revaldinho/opc/opc7hp/doc/manual_ch1.html

## 1.1Registers

r0 = 0

r1

r2

r3

r4

r5

r6

r7

r8

r9

r10

r11

r12

r13

r14

r15 = pc

- Sixteen 32-bit registers. Most instructions name a destination register, which is also their first operand, and a source register.
- r0 always reads as zero. Writing it is allowed and changes nothing, but the flags are still set from the result, so an operation with destination r0 serves as a test.
- r15 is the program counter. Read as a source, it gives the address of the next instruction. Writing it is a jump, and a jump leaves the flags unchanged.
- Addresses and the program counter are 20 bits, so the machine addresses 1M 32-bit words. Reading r15 gives zeros in the top 12 bits. Memory is word addressed: there are no byte loads or stores.
- By software convention, the BCPL code generator uses r13 as the link register and r14 as the stack pointer.

## 1.2Processor status register

31Voverflow

3080unused

74SWIsoft int

3EIint en

2Ssign

1Ccarry

0Zzero

- Z: the result is zero. S: bit 31 of the result is set. C: the carry out of an add, subtract or compare, or the bit shifted out by a shift or rotate. V: signed overflow from an add, subtract or compare.
- EI enables hardware interrupts. Writing a non-zero SWI value with putpsr raises a software interrupt.
- Only the instructions themselves set flags. The address and operand calculation (section 1.4) never does.
- The PSR is read with getpsr and written with putpsr. getpsr puts V in bit 31 of its result, which also sets S, so getpsr followed by mi. or pl. tests overflow.

## 1.3Instruction formats

Every instruction is one 32-bit word, in one of two formats.

### Standard: opcodes 0x00 to 0x1B

3129ppppred

2824oooooopcode

2320dddddst

1916sssssrc

150imm16operand, sign extended

### Long: opcodes 0x1C to 0x1F

3129ppppred

2824111ooopcode

2320dddddst

190imm20operand, sign extended

Both immediates are sign extended to 32 bits. A 16-bit immediate covers 0x0000 to 0x7FFF and 0xFFFF8000 to 0xFFFFFFFF. The exception is in and out, whose 16-bit I/O address space accepts any 16-bit constant. Load a full 32-bit constant with mov and then movt.

## 1.4Operand and address calculation

Every instruction first forms an effective address or data value, EAD. For the standard format, EAD = src + imm16. For the long format, EAD = imm20. The instruction then uses EAD as its operand, as a memory or I/O address, or as a jump target. Choosing r0 and a zero immediate gives these modes:

Mode | Written as | EAD | Used by
Immediate | mov r1, r0, 100 | imm16 | ALU instructions
Register | add r1, r2 | src | ALU instructions
Register + immediate | add r1, r2, 4 | src + imm16 | ALU instructions
Long immediate | lmov r1, 0x12345 | imm20 | lmov, ljsr
Direct | ld r1, r0, 0x200 | mem[imm16] | loads, stores, in, out
Indirect | ld r1, r2 | mem[src] | loads, stores, in, out
Indexed | ld r1, r2, 4 | mem[src + imm16] | loads, stores, in, out
Long direct | lld r1, 0x12345 | mem[imm20] | lld, lsto
PC relative | mov pc, pc, -3 | next pc + imm16 | jumps, data near the code

There are three exceptions. bperm takes src as its value and uses imm16 as a byte selector (section 1.6). getpsr reads the PSR and ignores the immediate. rti takes its target from the saved interrupt PC.

## 1.5Predicates

Every instruction carries a predicate in bits 31 to 29, written as a prefix to its mnemonic. If the predicate fails, the instruction does nothing at all and changes no flags.

Bits 31-29 | Prefix | Executes when
000 | none, or 1. | always
001 | 0. | never: a no-operation that leaves the flags alone
010 | z. | Z set
011 | nz. | Z clear
100 | c. | C set
101 | nc. | C clear
110 | mi. | S set
111 | pl. | S clear

V has no predicate of its own. For signed comparisons, scmp sets S to the true signed result, so scmp followed by mi. or pl. gives signed less-than or greater-or-equal.

## 1.6Instruction set

Op | Mnemonic | Operation | Flags
Moves and logic
00 | mov rd, rs, imm | rd ← EAD | S Z
01 | movt rd, rs, imm | rd ← {EAD[15:0], rd[15:0]} | S Z
02 | xor rd, rs, imm | rd ← rd ^ EAD | S Z
03 | and rd, rs, imm | rd ← rd & EAD | S Z
04 | or rd, rs, imm | rd ← rd | EAD | S Z
05 | not rd, rs, imm | rd ← ~EAD | S Z
09 | bperm rd, rs, sel | rd ← bytes of rs chosen by sel | S Z
Arithmetic and compare
08 | add rd, rs, imm | {C, rd} ← rd + EAD | V S C Z
07 | sub rd, rs, imm | {C, rd} ← rd + ~EAD + 1 | V S C Z
06 | cmp rd, rs, imm | rd + ~EAD + 1, result discarded | V S C Z
16 | scmp rd, rs, imm | as cmp, with S = sign of result ^ V | V S C Z
Shifts and rotates (one place)
0A | ror rd, rs, imm | {rd, C} ← {C, EAD} | S C Z
0B | lsr rd, rs, imm | {rd, C} ← {0, EAD} | S C Z
0D | asr rd, rs, imm | {rd, C} ← {EAD[31], EAD} | S C Z
0E | rol rd, rs, imm | {C, rd} ← {EAD, C} | S C Z
Multiply and divide steps (one bit each)
0F | mulstep rd, rs, imm | rd ← {rd[30:0], 0} + (C ? EAD : 0) | S Z
17 | divstep rd, rs, imm | t = {rd, C}; t ≥ EAD: {C, rd} ← {1, t − EAD}, else {C, rd} ← {0, t[31:0]} | S C Z
Memory and I/O
1B | ld rd, rs, imm | rd ← mem[EAD] | S Z
1F | lld rd, imm20 | rd ← mem[imm20] | S Z
1A | sto rd, rs, imm | mem[EAD] ← rd | –
1E | lsto rd, imm20 | mem[imm20] ← rd | –
19 | in rd, rs, imm | rd ← io[EAD] | S Z
18 | out rd, rs, imm | io[EAD] ← rd | –
Control
0C | jsr rd, rs, imm | rd ← next pc; pc ← EAD | S Z (of the link)
1C | ljsr rd, imm20 | rd ← next pc; pc ← imm20 | S Z (of the link)
1D | lmov rd, imm20 | rd ← imm20 | S Z
11 | rti pc, pc | pc ← saved pc; flags restored | restored
12 | putpsr psr, rs, imm | PSR ← EAD; a non-zero SWI interrupts | all
13 | getpsr rd, psr | rd ← PSR | S (= V) Z
10 | halt rd, rs, imm | stop (the end of a simulation; opc7hpcpu raises hlt) | n/a

- Writing r15 with any instruction except the compares is a jump: mov pc, add pc, ld pc and so on. A jump leaves all the flags unchanged. A compare with destination r15 just compares.
- Flags not listed for an instruction keep their values. In particular, C and V change only where shown.
- add rd, rd shifts left one place, with C taking the bit shifted out.
- bperm builds each byte of the result from a 4-bit field of the selector, with byte 3 on the left. Bits 1 and 0 of a field pick a byte of rs, and bit 2 makes the byte zero. For example, 0x3210 leaves rs unchanged, 0x0123 reverses its bytes and 0x4441 moves byte 1 to byte 0 and clears the rest.
- mulstep and divstep each do one bit of a software multiply or divide, the bit coming in through C. A 32-bit multiply is 32 × (add m, m; mulstep p, b), the multiplier's bits going into C from the top, and an unsigned divide is 32 × (rol n, n; divstep r, d) and a last rol n, n, the dividend's bits going out of n into C and the quotient bits in. divstep compares 33 bits, so it can also continue a longer division.
- Unused opcodes are 0x14 and 0x15.

## 1.7Reset and interrupts

- Reset starts execution at address 0 with interrupts disabled.
- Hardware interrupts come from int_b[1:0], active low, while EI is set. An interrupt is taken as an instruction completes, and enters the handler at address 0x0004 for int_b[1] or 0x0002 for int_b[0]. If both are low, int_b[1] wins. A software interrupt, from putpsr writing a non-zero SWI, also uses 0x0002, so the handler reads the PSR to tell them apart.
- Taking an interrupt saves the return address and the flags, then clears EI. rti pc, pc returns and restores them, with SWI cleared.
- On opc7hpcpu, interrupts are precise. Everything before the interrupted point has completed, nothing after it has had any effect, and a store, in or out already sent to memory is never repeated.

## 1.8The opc7hpcpu hardware interface

Signal | Meaning
iaddr[19:0], ird | instruction fetch request
idin[31:0] | instruction reply; held until the next fetch is taken
iwait | instruction port busy: the reply isn't ready and no request is taken
address[19:0], rnw, dout[31:0] | data request; a write supplies dout
vda / vio | the data request is to memory / to the 16-bit I/O space
din[31:0] | data reply, for loads and in
dwait | data port busy, as iwait
int_b[1:0] | hardware interrupts, active low
clken | stops the whole CPU while low
hlt | high for the cycle a halt completes, so a system can stop the CPU
reset_b, clk | reset (active low, synchronised inside) and clock

Each port carries one access at a time. A request is taken at the end of a cycle in which its wait is low. The reply comes in the first later cycle with the wait low, and a write is complete as soon as it is taken. Tie both waits low for single-cycle memory such as block RAM. The waits must not depend on the CPU's outputs in the same cycle.

## 1.9Timing

The original opc7cpu runs one instruction at a time through its fetch (FET), address (EAD), memory (RDM/WRM) and execute (EXEC) states. opc7hpcpu overlaps four pipeline stages: FD (fetch), EA (address), MEM (memory) and EX (execute). It starts one instruction per cycle, apart from the costs below, and averages about 1.33 cycles per instruction on the BCPL test programs.

Case | opc7cpu | opc7hpcpu
ALU instruction | 2 | 1
Load, in | 3 | 1
Store, out | 2, plus a fetch for the next | 1
Predicate fails | 1 | 1
Unpredicated mov/lmov to pc, jsr, ljsr | 2, plus a fetch | 2
Predicated jump to an immediate or pc-relative backward target | 2, plus a fetch, if taken | 2 if taken, 4 if not
Any other taken jump (forward predicated, add pc, ld pc, rti) | 2 or 3, plus a fetch | 4
Register written by the previous instruction, needed early: an address, a source with a non-zero immediate or for bperm, store data, a jump target | no extra | +2 (+1 if written two before)
Register needed only in EX: the ALU's operands | no extra | no extra (forwarded)

opc7cpu figures are for its default build. "Plus a fetch" is one cycle, which opc7cpu otherwise overlaps with the end of the previous instruction. On opc7hpcpu each cycle with iwait or dwait high adds one, for the port it holds up.

## 1.10Changes from the original OPC7 specification

- scmp (0x16) added for signed comparisons. The original table showed it as cmp.
- Predicate 001, written 0., means never execute in all the CPUs, both emulators and the assembler. The original opc7cpu executed it.
- getpsr used to clear C in the copy it read. It now reads the PSR as it is.
- in sets S and Z from the value read, and out leaves the flags alone, the same as loads and stores.
- asr shifts in bit 31; the original table said bit 15. Shifts and rotates set C, and stores, out, writes to r15 and rti leave Z alone, which the original flag notes didn't say.
- The long forms are written ljsr, lmov, lsto and lld.
- An interrupt saves V along with the other flags, and rti restores it, as the emulators always did. The RTL used to clear V on rti.
- opc7hpcpu adds the Harvard ports, the iwait and dwait inputs and the hlt output. Interrupts are precise.
