revaldinho/opc/opc7hp/doc/opc7hp_manual.html

OPC7HP manual · draft

# OPC7HP: the Harvard, pipelined OPC7

Chapter 1 summarises the machine for programmers. Chapter 2 gives each instruction its own page, after the instruction reference in Rodnay Zaks's Programming the Z80.

## 1Programmer's summary

## 1.1Registers

r0 = 0

r1

r2

r3

r4

r5

r6

r7

r8

r9

r10

r11

r12

r13

r14

r15 = pc

- Sixteen 32-bit registers. Most instructions name a destination register, which is also their first operand, and a source register.
- r0 always reads as zero. Writing it is allowed and changes nothing, but the flags are still set from the result, so an operation with destination r0 serves as a test.
- r15 is the program counter. Read as a source, it gives the address of the next instruction. Writing it is a jump, and a jump leaves the flags unchanged.
- Addresses and the program counter are 20 bits, so the machine addresses 1M 32-bit words. Reading r15 gives zeros in the top 12 bits. Memory is word addressed: there are no byte loads or stores.
- By software convention, the BCPL code generator uses r13 as the link register and r14 as the stack pointer.

## 1.2Processor status register

31Voverflow

3080unused

74SWIsoft int

3EIint en

2Ssign

1Ccarry

0Zzero

- Z: the result is zero. S: bit 31 of the result is set. C: the carry out of an add, subtract or compare, or the bit shifted out by a shift or rotate. V: signed overflow from an add, subtract or compare.
- EI enables hardware interrupts. Writing a non-zero SWI value with putpsr raises a software interrupt.
- Only the instructions themselves set flags. The address and operand calculation (section 1.4) never does.
- The PSR is read with getpsr and written with putpsr. getpsr puts V in bit 31 of its result, which also sets S, so getpsr followed by mi. or pl. tests overflow.

## 1.3Instruction formats

Every instruction is one 32-bit word, in one of two formats.

### Standard: opcodes 0x00 to 0x1B

3129ppppred

2824oooooopcode

2320dddddst

1916sssssrc

150imm16operand, sign extended

### Long: opcodes 0x1C to 0x1F

3129ppppred

2824111ooopcode

2320dddddst

190imm20operand, sign extended

Both immediates are sign extended to 32 bits. A 16-bit immediate covers 0x0000 to 0x7FFF and 0xFFFF8000 to 0xFFFFFFFF. The exception is in and out, whose 16-bit I/O address space accepts any 16-bit constant. Load a full 32-bit constant with mov and then movt.

## 1.4Operand and address calculation

Every instruction first forms an effective address or data value, EAD. For the standard format, EAD = src + imm16. For the long format, EAD = imm20. The instruction then uses EAD as its operand, as a memory or I/O address, or as a jump target. Choosing r0 and a zero immediate gives these modes:

Mode | Written as | EAD | Used by
Immediate | mov r1, r0, 100 | imm16 | ALU instructions
Register | add r1, r2 | src | ALU instructions
Register + immediate | add r1, r2, 4 | src + imm16 | ALU instructions
Long immediate | lmov r1, 0x12345 | imm20 | lmov, ljsr
Direct | ld r1, r0, 0x200 | mem[imm16] | loads, stores, in, out
Indirect | ld r1, r2 | mem[src] | loads, stores, in, out
Indexed | ld r1, r2, 4 | mem[src + imm16] | loads, stores, in, out
Long direct | lld r1, 0x12345 | mem[imm20] | lld, lsto
PC relative | mov pc, pc, -3 | next pc + imm16 | jumps, data near the code

There are three exceptions. bperm takes src as its value and uses imm16 as a byte selector (section 1.6). getpsr reads the PSR and ignores the immediate. rti takes its target from the saved interrupt PC.

## 1.5Predicates

Every instruction carries a predicate in bits 31 to 29, written as a prefix to its mnemonic. If the predicate fails, the instruction does nothing at all and changes no flags.

Bits 31-29 | Prefix | Executes when
000 | none, or 1. | always
001 | 0. | never: a no-operation that leaves the flags alone
010 | z. | Z set
011 | nz. | Z clear
100 | c. | C set
101 | nc. | C clear
110 | mi. | S set
111 | pl. | S clear

V has no predicate of its own. For signed comparisons, scmp sets S to the true signed result, so scmp followed by mi. or pl. gives signed less-than or greater-or-equal.

## 1.6Instruction set

Op | Mnemonic | Operation | Flags
Moves and logic
00 | mov rd, rs, imm | rd ← EAD | S Z
01 | movt rd, rs, imm | rd ← {EAD[15:0], rd[15:0]} | S Z
02 | xor rd, rs, imm | rd ← rd ^ EAD | S Z
03 | and rd, rs, imm | rd ← rd & EAD | S Z
04 | or rd, rs, imm | rd ← rd | EAD | S Z
05 | not rd, rs, imm | rd ← ~EAD | S Z
09 | bperm rd, rs, sel | rd ← bytes of rs chosen by sel | S Z
Arithmetic and compare
08 | add rd, rs, imm | {C, rd} ← rd + EAD | V S C Z
07 | sub rd, rs, imm | {C, rd} ← rd + ~EAD + 1 | V S C Z
06 | cmp rd, rs, imm | rd + ~EAD + 1, result discarded | V S C Z
16 | scmp rd, rs, imm | as cmp, with S = sign of result ^ V | V S C Z
Shifts and rotates (one place)
0A | ror rd, rs, imm | {rd, C} ← {C, EAD} | S C Z
0B | lsr rd, rs, imm | {rd, C} ← {0, EAD} | S C Z
0D | asr rd, rs, imm | {rd, C} ← {EAD[31], EAD} | S C Z
0E | rol rd, rs, imm | {C, rd} ← {EAD, C} | S C Z
Multiply and divide steps (one bit each)
0F | mulstep rd, rs, imm | rd ← {rd[30:0], 0} + (C ? EAD : 0) | S Z
17 | divstep rd, rs, imm | t = {rd, C}; t ≥ EAD: {C, rd} ← {1, t − EAD}, else {C, rd} ← {0, t[31:0]} | S C Z
Memory and I/O
1B | ld rd, rs, imm | rd ← mem[EAD] | S Z
1F | lld rd, imm20 | rd ← mem[imm20] | S Z
1A | sto rd, rs, imm | mem[EAD] ← rd | –
1E | lsto rd, imm20 | mem[imm20] ← rd | –
19 | in rd, rs, imm | rd ← io[EAD] | S Z
18 | out rd, rs, imm | io[EAD] ← rd | –
Control
0C | jsr rd, rs, imm | rd ← next pc; pc ← EAD | S Z (of the link)
1C | ljsr rd, imm20 | rd ← next pc; pc ← imm20 | S Z (of the link)
1D | lmov rd, imm20 | rd ← imm20 | S Z
11 | rti pc, pc | pc ← saved pc; flags restored | restored
12 | putpsr psr, rs, imm | PSR ← EAD; a non-zero SWI interrupts | all
13 | getpsr rd, psr | rd ← PSR | S (= V) Z
10 | halt rd, rs, imm | stop (the end of a simulation; opc7hpcpu raises hlt) | n/a

- Writing r15 with any instruction except the compares is a jump: mov pc, add pc, ld pc and so on. A jump leaves all the flags unchanged. A compare with destination r15 just compares.
- Flags not listed for an instruction keep their values. In particular, C and V change only where shown.
- add rd, rd shifts left one place, with C taking the bit shifted out.
- bperm builds each byte of the result from a 4-bit field of the selector, with byte 3 on the left. Bits 1 and 0 of a field pick a byte of rs, and bit 2 makes the byte zero. For example, 0x3210 leaves rs unchanged, 0x0123 reverses its bytes and 0x4441 moves byte 1 to byte 0 and clears the rest.
- mulstep and divstep each do one bit of a software multiply or divide, the bit coming in through C. A 32-bit multiply is 32 × (add m, m; mulstep p, b), the multiplier's bits going into C from the top, and an unsigned divide is 32 × (rol n, n; divstep r, d) and a last rol n, n, the dividend's bits going out of n into C and the quotient bits in. divstep compares 33 bits, so it can also continue a longer division.
- Unused opcodes are 0x14 and 0x15.

## 1.7Reset and interrupts

- Reset starts execution at address 0 with interrupts disabled.
- Hardware interrupts come from int_b[1:0], active low, while EI is set. An interrupt is taken as an instruction completes, and enters the handler at address 0x0004 for int_b[1] or 0x0002 for int_b[0]. If both are low, int_b[1] wins. A software interrupt, from putpsr writing a non-zero SWI, also uses 0x0002, so the handler reads the PSR to tell them apart.
- Taking an interrupt saves the return address and the flags, then clears EI. rti pc, pc returns and restores them, with SWI cleared.
- On opc7hpcpu, interrupts are precise. Everything before the interrupted point has completed, nothing after it has had any effect, and a store, in or out already sent to memory is never repeated.

## 1.8The opc7hpcpu hardware interface

Signal | Meaning
iaddr[19:0], ird | instruction fetch request
idin[31:0] | instruction reply; held until the next fetch is taken
iwait | instruction port busy: the reply isn't ready and no request is taken
address[19:0], rnw, dout[31:0] | data request; a write supplies dout
vda / vio | the data request is to memory / to the 16-bit I/O space
din[31:0] | data reply, for loads and in
dwait | data port busy, as iwait
int_b[1:0] | hardware interrupts, active low
clken | stops the whole CPU while low
hlt | high for the cycle a halt completes, so a system can stop the CPU
reset_b, clk | reset (active low, synchronised inside) and clock

Each port carries one access at a time. A request is taken at the end of a cycle in which its wait is low. The reply comes in the first later cycle with the wait low, and a write is complete as soon as it is taken. Tie both waits low for single-cycle memory such as block RAM. The waits must not depend on the CPU's outputs in the same cycle.

## 1.9Timing

The original opc7cpu runs one instruction at a time through its fetch (FET), address (EAD), memory (RDM/WRM) and execute (EXEC) states. opc7hpcpu overlaps four pipeline stages: FD (fetch), EA (address), MEM (memory) and EX (execute). It starts one instruction per cycle, apart from the costs below, and averages about 1.33 cycles per instruction on the BCPL test programs.

Case | opc7cpu | opc7hpcpu
ALU instruction | 2 | 1
Load, in | 3 | 1
Store, out | 2, plus a fetch for the next | 1
Predicate fails | 1 | 1
Unpredicated mov/lmov to pc, jsr, ljsr | 2, plus a fetch | 2
Predicated jump to an immediate or pc-relative backward target | 2, plus a fetch, if taken | 2 if taken, 4 if not
Any other taken jump (forward predicated, add pc, ld pc, rti) | 2 or 3, plus a fetch | 4
Register written by the previous instruction, needed early: an address, a source with a non-zero immediate or for bperm, store data, a jump target | no extra | +2 (+1 if written two before)
Register needed only in EX: the ALU's operands | no extra | no extra (forwarded)

opc7cpu figures are for its default build. "Plus a fetch" is one cycle, which opc7cpu otherwise overlaps with the end of the previous instruction. On opc7hpcpu each cycle with iwait or dwait high adds one, for the port it holds up.

## 1.10Changes from the original OPC7 specification

- scmp (0x16) added for signed comparisons. The original table showed it as cmp.
- Predicate 001, written 0., means never execute in all the CPUs, both emulators and the assembler. The original opc7cpu executed it.
- getpsr used to clear C in the copy it read. It now reads the PSR as it is.
- in sets S and Z from the value read, and out leaves the flags alone, the same as loads and stores.
- asr shifts in bit 31; the original table said bit 15. Shifts and rotates set C, and stores, out, writes to r15 and rti leave Z alone, which the original flag notes didn't say.
- The long forms are written ljsr, lmov, lsto and lld.
- An interrupt saves V along with the other flags, and rti restores it, as the emulators always did. The RTL used to clear V on rti.
- opc7hpcpu adds the Harvard ports, the iwait and dwait inputs and the hlt output. Interrupts are precise.

## 2Instruction reference

ADD

Addopcode 0x08

Function

{C, dst} ← dst + (src + imm16)

Format

3129p p ppred

28240 1 0 0 0opcode

2320d d d ddst

1916s s s ssrc

150i i i i i i i i i i i i i i i iimm16, sign extended

Assembler: [pred.]add dst, src[, imm]; the immediate defaults to 0. One word.

Description

The source register and the sign-extended immediate are added to form the operand. The operand is then added to the destination register, and the 32-bit sum replaces it.

C is the carry out of bit 31 and V is set on signed overflow. add rd, rd shifts left one place.

Data paths

Flags

V•

SWI–

EI–

S•

C•

Z•

• set; – unchanged.

Timing

Processor | Clock cycles
opc7cpu | 2 (EAD, EXEC); 3 after a store, a jump or a skipped instruction, which need a separate fetch. 1 if the predicate fails.
opc7hpcpu | 1. The result reaches the next instruction's ALU operands without a wait. An instruction that needs it earlier, as an address, store data, a jump target, a bperm source or a source with a non-zero immediate, waits up to 2 cycles. This instruction's own source is needed early in the same way when its immediate is not zero.

Examples

Instruction | Word | Effect
add r1, r2, 0x10 | 08120010 | r1 ← r1 + r2 + 16
add r4, r4 | 08440000 | r4 ← 2 × r4; C holds the bit shifted out
nz.add r3, r0, -1 | 6830FFFF | if Z is clear, r3 ← r3 − 1
add pc, r0, 3 | 08F00003 | skip the next 3 instructions; flags kept

AND

Andopcode 0x03

Function

dst ← dst & (src + imm16)

Format

3129p p ppred

28240 0 0 1 1opcode

2320d d d ddst

1916s s s ssrc

150i i i i i i i i i i i i i i i iimm16, sign extended

Assembler: [pred.]and dst, src[, imm]; the immediate defaults to 0. One word.

Description

The destination register is anded with the source plus the immediate.

As the immediate is sign extended, a mask of 0x8000 or more in it also sets the top 16 bits. Masks such as 0xFF and 0x7FFF are fine.

Data paths

Flags

V–

SWI–

EI–

S•

C–

Z•

• set; – unchanged.

Timing

Processor | Clock cycles
opc7cpu | 2 (EAD, EXEC); 3 after a store, a jump or a skipped instruction, which need a separate fetch. 1 if the predicate fails.
opc7hpcpu | 1. The result reaches the next instruction's ALU operands without a wait. An instruction that needs it earlier, as an address, store data, a jump target, a bperm source or a source with a non-zero immediate, waits up to 2 cycles. This instruction's own source is needed early in the same way when its immediate is not zero.

Examples

Instruction | Word | Effect
and r1, r0, 0xFF | 031000FF | keep the low byte of r1
and r2, r3 | 03230000 | r2 ← r2 & r3
and r4, r0, 1 | 03400001 | Z set if r4 is even

ASR

Arithmetic shift rightopcode 0x0D

Function

{dst, C} ← {(src + imm16)[31], src + imm16}

Format

3129p p ppred

28240 1 1 0 1opcode

2320d d d ddst

1916s s s ssrc

150i i i i i i i i i i i i i i i iimm16, sign extended

Assembler: [pred.]asr dst, src[, imm]; the immediate defaults to 0. One word.

Description

The source plus the immediate is shifted right one place. Bit 31 keeps its value, so the sign is kept, and bit 0 goes into C.

This divides a signed number by two, rounding towards minus infinity.

Data paths

Flags

V–

SWI–

EI–

S•

C•

Z•

• set; – unchanged.

Timing

Processor | Clock cycles
opc7cpu | 2 (EAD, EXEC); 3 after a store, a jump or a skipped instruction, which need a separate fetch. 1 if the predicate fails.
opc7hpcpu | 1. The result reaches the next instruction's ALU operands without a wait. An instruction that needs it earlier, as an address, store data, a jump target, a bperm source or a source with a non-zero immediate, waits up to 2 cycles. This instruction's own source is needed early in the same way when its immediate is not zero.

Examples

Instruction | Word | Effect
asr r1, r1 | 0D110000 | r1 ← r1 / 2, signed
asr r2, r3 | 0D230000 | r2 ← r3 / 2, signed

BPERM

Byte permuteopcode 0x09

Function

dst ← bytes of src, chosen by imm16

Format

3129p p ppred

28240 1 0 0 1opcode

2320d d d ddst

1916s s s ssrc

150i i i i i i i i i i i i i i i iimm16, sign extended

Assembler: [pred.]bperm dst, src[, imm]; the immediate defaults to 0. One word.

Description

Each byte of the result comes from the source register as directed by a 4-bit field of the immediate. The fields are in byte order, so the leftmost hex digit controls byte 3, the top byte.

In each field, bits 1 and 0 pick a byte of the source and bit 2 makes the result byte zero instead. Unlike other instructions, the immediate isn't added to the source.

Data paths

Flags

V–

SWI–

EI–

S•

C–

Z•

• set; – unchanged.

Timing

Processor | Clock cycles
opc7cpu | 2 (EAD, EXEC); 3 after a store, a jump or a skipped instruction, which need a separate fetch. 1 if the predicate fails.
opc7hpcpu | 1. The result reaches the next instruction's ALU operands without a wait. An instruction that needs it earlier, as an address, store data, a jump target, a bperm source or a source with a non-zero immediate, waits up to 2 cycles. This instruction's own source is needed early in the same way when its immediate is not zero.

Examples

Instruction | Word | Effect
bperm r1, r2, 0x3210 | 09123210 | r1 ← r2 unchanged
bperm r1, r2, 0x0123 | 09120123 | reverse the bytes
bperm r1, r2, 0x0321 | 09120321 | rotate right by a byte
bperm r1, r2, 0x4441 | 09124441 | byte 1 of r2 to byte 0, the rest zero
bperm r1, r2, 0x0000 | 09120000 | byte 0 copied to all four

CMP

Compareopcode 0x06

Function

dst − (src + imm16), result discarded

Format

3129p p ppred

28240 0 1 1 0opcode

2320d d d ddst

1916s s s ssrc

150i i i i i i i i i i i i i i i iimm16, sign extended

Assembler: [pred.]cmp dst, src[, imm]; the immediate defaults to 0. One word.

Description

The source plus the immediate is subtracted from the destination register, as sub does, but only the flags keep the result.

Z is set if the two are equal. C is set if the destination is greater than or equal to the operand as unsigned numbers, since the subtraction is done as dst + ~operand + 1. For signed comparisons, use scmp.

With r15 as the destination it compares the next instruction's address and doesn't jump.

Data paths

Flags

V•

SWI–

EI–

S•

C•

Z•

• set; – unchanged.

Timing

Processor | Clock cycles
opc7cpu | 2 (EAD, EXEC); 3 after a store, a jump or a skipped instruction. 1 if the predicate fails.
opc7hpcpu | 1. The flags are ready for a predicated instruction straight after it. Its source is needed early when the immediate is not zero.

Examples

Instruction | Word | Effect
cmp r1, r2 | 06120000 | compare r1 with r2
cmp r1, r0, 10 | 0610000A | compare r1 with 10
z.mov r3, r0, 1 | 40300001 | after it: r3 ← 1 if they were equal
nc.mov pc, r0, 0x200 | A0F00200 | after it: jump if r1 < 10, unsigned

DIVSTEP

Divide stepopcode 0x17

Function

t = {dst, C}; {C, dst} ← t ≥ EAD ? {1, t − EAD} : {0, t[31:0]}

Format

3129p p ppred

28241 0 1 1 1opcode

2320d d d ddst

1916s s s ssrc

150i i i i i i i i i i i i i i i iimm16, sign extended

Assembler: [pred.]divstep dst, src[, imm]; the immediate defaults to 0. One word.

Description

One bit of a shift-and-subtract (restoring) divide. The destination, a partial remainder, is shifted left one place with C coming in at the bottom, giving a 33-bit value. If that is at least the source plus the immediate (unsigned), the operand is subtracted and C is set; otherwise it is kept and C is cleared. C is then the next quotient bit.

An unsigned 32-bit divide: clear the remainder and C, then 32 times rol n, n (the quotient bit from C in at the bottom of n, the next dividend bit out of its top into C) and divstep r, d, and a last rol n, n. n then holds the quotient and r the remainder. The comparison is of 33 bits, so the same steps also continue a division of a longer dividend.

Data paths

Flags

V–

SWI–

EI–

S•

C•

Z•

• set; – unchanged. C = the quotient bit.

Timing

Processor | Clock cycles
opc7cpu | 2 (EAD, EXEC); 3 after a store, a jump or a skipped instruction, which need a separate fetch. 1 if the predicate fails.
opc7hpcpu | 1. The result reaches the next instruction's ALU operands without a wait. An instruction that needs it earlier, as an address, store data, a jump target, a bperm source or a source with a non-zero immediate, waits up to 2 cycles. This instruction's own source is needed early in the same way when its immediate is not zero.

Examples

Instruction | Word | Effect
rol r1, r1 | 0E110000 | quotient bit in, next dividend bit out to C
divstep r3, r2 | 17320000 | r3 ← 2 × r3 + C, less r2 if that is ≥ r2; C ← the quotient bit
divstep r3, r0, 10 | 1730000A | one bit of a divide by 10

GETPSR

Get processor status registeropcode 0x13

Function

dst ← PSR

Format

3129p p ppred

28241 0 0 1 1opcode

2320d d d ddst

1916s s s ssrc

150i i i i i i i i i i i i i i i iimm16, sign extended

Assembler: [pred.]getpsr dst, psr. One word.

Description

The PSR is copied to the destination register. The immediate is ignored.

V is in bit 31 of the copy, so the S flag that the copy sets equals V. That makes getpsr then mi. or pl. a test for overflow.

Data paths

Flags

V–

SWI–

EI–

S•

C–

Z•

• set; – unchanged. S = V.

Timing

Processor | Clock cycles
opc7cpu | 2 (EAD, EXEC); 3 after a store, a jump or a skipped instruction, which need a separate fetch. 1 if the predicate fails.
opc7hpcpu | 1. The result reaches the next instruction's ALU operands without a wait. An instruction that needs it earlier, as an address, store data, a jump target, a bperm source or a source with a non-zero immediate, waits up to 2 cycles. This instruction's own source is needed early in the same way when its immediate is not zero.

Examples

Instruction | Word | Effect
getpsr r1, psr | 13100000 | r1 ← PSR
getpsr r0, psr | 13000000 | only set S from V
mi.mov pc, r0, 0x300 | C0F00300 | after it: jump if V was set

HALT

Haltopcode 0x10

Function

stop

Format

3129p p ppred

28241 0 0 0 0opcode

2320d d d ddst

1916s s s ssrc

150i i i i i i i i i i i i i i i iimm16, sign extended

Assembler: halt r0, r0, number. One word.

Description

Ends a program. The emulators and testbenches stop and report the immediate as the halt number.

On opc7hpcpu the instruction raises the hlt output as it completes, and the system around it stops the CPU there. The CPU itself carries on.

Data paths

Flags

V–

SWI–

EI–

S–

C–

Z–

N/a.

Timing

Processor | Clock cycles
opc7cpu | n/a
opc7hpcpu | The CPU is stopped by the system as halt completes.

Examples

Instruction | Word | Effect
halt r0, r0, 0x99 | 10000099 | stop, halt number 0x99

IN

Inputopcode 0x19

Function

dst ← io[src + imm16]

Format

3129p p ppred

28241 1 0 0 1opcode

2320d d d ddst

1916s s s ssrc

150i i i i i i i i i i i i i i i iimm16, sign extended

Assembler: [pred.]in dst, src[, imm]; the immediate defaults to 0. One word.

Description

The I/O port at the source plus the immediate is read into the destination register, which sets S and Z. The access uses vio, and the port address is 16 bits.

In the emulators, every in reads the next character of standard input, whatever the port.

Data paths

Flags

V–

SWI–

EI–

S•

C–

Z•

• set; – unchanged.

Timing

Processor | Clock cycles
opc7cpu | 3 (EAD, RDM, EXEC); 4 after a store, a jump or a skipped instruction. 1 if the predicate fails.
opc7hpcpu | 1, with memory that answers at once. Its address register is needed early: up to 2 cycles' wait if one of the two instructions before wrote it. The value read reaches the next instruction's ALU operands without a wait, and an address 2 cycles later. Each cycle the port's wait input is high adds one.

Examples

Instruction | Word | Effect
in r1, r0, 0x00 | 19100000 | read port 0 (the system UART's status)
in r2, r0, 0x10 | 19200010 | read the GPIO input pins

JSR

Jump to subroutineopcode 0x0C

Function

dst ← next pc; pc ← src + imm16

Format

3129p p ppred

28240 1 1 0 0opcode

2320d d d ddst

1916s s s ssrc

150i i i i i i i i i i i i i i i iimm16, sign extended

Assembler: [pred.]jsr dst, src[, imm]; the immediate defaults to 0. One word.

Description

The address of the next instruction is saved in the destination register, the link, and execution continues at the source plus the immediate.

Return with mov pc, rlink. BCPL code uses r13 as the link. With r0 as the destination it is a plain jump.

Data paths

Flags

V–

SWI–

EI–

S•

C–

Z•

• set; – unchanged. Of the link.

Timing

Processor | Clock cycles
opc7cpu | 2, and the target then needs a separate fetch. 1 if the predicate fails.
opc7hpcpu | 2 when unpredicated: it redirects the fetch as it leaves EA, losing one cycle. Its source is needed early. A predicated one with an immediate or pc-relative backward target is predicted taken: 2 if it is, 4 if not. Any other taken jump of this kind costs 4.

Examples

Instruction | Word | Effect
jsr r13, r0, 0x1234 | 0CD01234 | call the routine at 0x1234
jsr r13, r4 | 0CD40000 | call through r4
mov pc, r13 | 00FD0000 | and return

LD

Loadopcode 0x1B

Function

dst ← mem[src + imm16]

Format

3129p p ppred

28241 1 0 1 1opcode

2320d d d ddst

1916s s s ssrc

150i i i i i i i i i i i i i i i iimm16, sign extended

Assembler: [pred.]ld dst, src[, imm]; the immediate defaults to 0. One word.

Description

The source register and the sign-extended immediate are added to form a word address. Its low 20 bits select one of the 1M words of memory, and that word replaces the destination register.

With r0 as the source the immediate is an absolute address in the first 32K words, and lld reaches all 1M. A destination of r15 jumps to the loaded address, as through a jump table.

Data paths

Flags

V–

SWI–

EI–

S•

C–

Z•

• set; – unchanged.

Timing

Processor | Clock cycles
opc7cpu | 3 (EAD, RDM, EXEC); 4 after a store, a jump or a skipped instruction. 1 if the predicate fails.
opc7hpcpu | 1, with memory that answers at once. Its address register is needed early: up to 2 cycles' wait if one of the two instructions before wrote it. The value read reaches the next instruction's ALU operands without a wait, and an address 2 cycles later. Each cycle the port's wait input is high adds one.

Examples

Instruction | Word | Effect
ld r1, r2, 4 | 1B120004 | r1 ← the word 4 after r2
ld r5, r11, -2 | 1B5BFFFE | r5 ← the word 2 before r11
mi.ld r6, r12, 94 | DB6C005E | if S is set, r6 ← mem[r12 + 94]
ld pc, r0, 0x200 | 1BF00200 | jump to the address held at 0x200

LJSR

Long jump to subroutineopcode 0x1C

Function

dst ← next pc; pc ← imm20

Format

3129p p ppred

28241 1 1 0 0opcode

2320d d d ddst

190i i i i i i i i i i i i i i i i i i i iimm20, sign extended

Assembler: [pred.]ljsr dst, imm20. Long format: no source field. One word.

Description

As jsr, with the target a 20-bit address in the instruction, so it reaches the whole address space.

Data paths

Flags

V–

SWI–

EI–

S•

C–

Z•

• set; – unchanged. Of the link.

Timing

Processor | Clock cycles
opc7cpu | 2, and the target then needs a separate fetch. 1 if the predicate fails.
opc7hpcpu | 2 when unpredicated: it redirects the fetch as it leaves EA, losing one cycle. Its source is needed early. A predicated one with an immediate or pc-relative backward target is predicted taken: 2 if it is, 4 if not. Any other taken jump of this kind costs 4.

Examples

Instruction | Word | Effect
ljsr r13, 0x1000 | 1CD01000 | call the routine at 0x01000

LLD

Long loadopcode 0x1F

Function

dst ← mem[imm20]

Format

3129p p ppred

28241 1 1 1 1opcode

2320d d d ddst

190i i i i i i i i i i i i i i i i i i i iimm20, sign extended

Assembler: [pred.]lld dst, imm20. Long format: no source field. One word.

Description

The word at the 20-bit address in the instruction replaces the destination register.

Data paths

Flags

V–

SWI–

EI–

S•

C–

Z•

• set; – unchanged.

Timing

Processor | Clock cycles
opc7cpu | 3 (EAD, RDM, EXEC); 4 after a store, a jump or a skipped instruction. 1 if the predicate fails.
opc7hpcpu | 1, with memory that answers at once. Its address register is needed early: up to 2 cycles' wait if one of the two instructions before wrote it. The value read reaches the next instruction's ALU operands without a wait, and an address 2 cycles later. Each cycle the port's wait input is high adds one.

Examples

Instruction | Word | Effect
lld r1, 0x12345 | 1F112345 | r1 ← mem[0x12345]
lld pc, 0x00010 | 1FF00010 | jump to the address held at 0x10

LMOV

Long moveopcode 0x1D

Function

dst ← imm20

Format

3129p p ppred

28241 1 1 0 1opcode

2320d d d ddst

190i i i i i i i i i i i i i i i i i i i iimm20, sign extended

Assembler: [pred.]lmov dst, imm20. Long format: no source field. One word.

Description

The sign-extended 20-bit immediate replaces the destination register, giving constants from −524288 to 524287 in one instruction.

With r15 as the destination it is a jump to any address.

Data paths

Flags

V–

SWI–

EI–

S•

C–

Z•

• set; – unchanged.

Timing

Processor | Clock cycles
opc7cpu | 2 (EAD, EXEC); 3 after a store, a jump or a skipped instruction, which need a separate fetch. 1 if the predicate fails.
opc7hpcpu | 1. The result reaches the next instruction's ALU operands without a wait. An instruction that needs it earlier, as an address, store data, a jump target, a bperm source or a source with a non-zero immediate, waits up to 2 cycles. This instruction's own source is needed early in the same way when its immediate is not zero.

Examples

Instruction | Word | Effect
lmov r1, 0x12345 | 1D112345 | r1 ← 0x12345
lmov r2, -100000 | 1D2E7960 | r2 ← −100000
lmov pc, 0x1000 | 1DF01000 | jump to 0x01000

LSR

Logical shift rightopcode 0x0B

Function

{dst, C} ← {0, src + imm16}

Format

3129p p ppred

28240 1 0 1 1opcode

2320d d d ddst

1916s s s ssrc

150i i i i i i i i i i i i i i i iimm16, sign extended

Assembler: [pred.]lsr dst, src[, imm]; the immediate defaults to 0. One word.

Description

The source plus the immediate is shifted right one place. Zero goes into bit 31, and bit 0 goes into C.

Data paths

Flags

V–

SWI–

EI–

S•

C•

Z•

• set; – unchanged.

Timing

Processor | Clock cycles
opc7cpu | 2 (EAD, EXEC); 3 after a store, a jump or a skipped instruction, which need a separate fetch. 1 if the predicate fails.
opc7hpcpu | 1. The result reaches the next instruction's ALU operands without a wait. An instruction that needs it earlier, as an address, store data, a jump target, a bperm source or a source with a non-zero immediate, waits up to 2 cycles. This instruction's own source is needed early in the same way when its immediate is not zero.

Examples

Instruction | Word | Effect
lsr r1, r1 | 0B110000 | r1 ← r1 / 2, unsigned
lsr r2, r3 | 0B230000 | r2 ← r3 / 2, unsigned; C holds the remainder

LSTO

Long storeopcode 0x1E

Function

mem[imm20] ← dst

Format

3129p p ppred

28241 1 1 1 0opcode

2320d d d ddst

190i i i i i i i i i i i i i i i i i i i iimm20, sign extended

Assembler: [pred.]lsto dst, imm20. Long format: no source field. One word.

Description

The destination register is written to the 20-bit address in the instruction. The flags are unchanged.

Data paths

Flags

V–

SWI–

EI–

S–

C–

Z–

Unchanged.

Timing

Processor | Clock cycles
opc7cpu | 2 (EAD, WRM), and the next instruction then needs a separate fetch. 1 if the predicate fails.
opc7hpcpu | 1. Its address and its data register are both needed early: up to 2 cycles' wait if one of the two instructions before wrote them. It waits while a jump or anything else that could change the flow is ahead of it in the pipeline, so that it never acts and is then cancelled.

Examples

Instruction | Word | Effect
lsto r1, 0x12345 | 1E112345 | mem[0x12345] ← r1

MOV

Moveopcode 0x00

Function

dst ← src + imm16

Format

3129p p ppred

28240 0 0 0 0opcode

2320d d d ddst

1916s s s ssrc

150i i i i i i i i i i i i i i i iimm16, sign extended

Assembler: [pred.]mov dst, src[, imm]; the immediate defaults to 0. One word.

Description

The source register plus the sign-extended immediate replaces the destination register.

With r0 as the source this loads a constant from −32768 to 32767. Use movt after it for the top half of a 32-bit constant, or lmov for 20 bits.

With r15 as the destination it is a jump: to an absolute address with r0 as the source, relative to the next instruction with r15, or through a register, as in mov pc, r13 to return from a subroutine.

Data paths

Flags

V–

SWI–

EI–

S•

C–

Z•

• set; – unchanged.

Timing

Processor | Clock cycles
opc7cpu | 2 (EAD, EXEC); 3 after a store, a jump or a skipped instruction, which need a separate fetch. 1 if the predicate fails.
opc7hpcpu | 1. The result reaches the next instruction's ALU operands without a wait. An instruction that needs it earlier, as an address, store data, a jump target, a bperm source or a source with a non-zero immediate, waits up to 2 cycles. This instruction's own source is needed early in the same way when its immediate is not zero.

Examples

Instruction | Word | Effect
mov r1, r0, 100 | 00100064 | r1 ← 100
mov r2, r3 | 00230000 | r2 ← r3
mov r4, r5, -1 | 0045FFFF | r4 ← r5 − 1
mov pc, r13 | 00FD0000 | return through the link in r13
nz.mov pc, pc, -3 | 60FFFFFD | if Z is clear, jump back 2 instructions

MOVT

Move topopcode 0x01

Function

dst ← {(src + imm16)[15:0], dst[15:0]}

Format

3129p p ppred

28240 0 0 0 1opcode

2320d d d ddst

1916s s s ssrc

150i i i i i i i i i i i i i i i iimm16, sign extended

Assembler: [pred.]movt dst, src[, imm]; the immediate defaults to 0. One word.

Description

The low 16 bits of the source plus the immediate replace the top half of the destination register. Its bottom half is unchanged.

After a mov of the low half, this completes a 32-bit constant.

Data paths

Flags

V–

SWI–

EI–

S•

C–

Z•

• set; – unchanged.

Timing

Processor | Clock cycles
opc7cpu | 2 (EAD, EXEC); 3 after a store, a jump or a skipped instruction, which need a separate fetch. 1 if the predicate fails.
opc7hpcpu | 1. The result reaches the next instruction's ALU operands without a wait. An instruction that needs it earlier, as an address, store data, a jump target, a bperm source or a source with a non-zero immediate, waits up to 2 cycles. This instruction's own source is needed early in the same way when its immediate is not zero.

Examples

Instruction | Word | Effect
mov r1, r0, 0x5678 | 00105678 | r1 ← 0x00005678
movt r1, r0, 0x1234 | 01101234 | r1 ← 0x12345678
movt r2, r0 | 01200000 | clear the top half of r2

MULSTEP

Multiply stepopcode 0x0F

Function

dst ← {dst[30:0], 0} + (C ? src + imm16 : 0)

Format

3129p p ppred

28240 1 1 1 1opcode

2320d d d ddst

1916s s s ssrc

150i i i i i i i i i i i i i i i iimm16, sign extended

Assembler: [pred.]mulstep dst, src[, imm]; the immediate defaults to 0. One word.

Description

One bit of a shift-and-add multiply. The destination is shifted left one place, and if C is set the source plus the immediate is added to it. C and V are left alone, so the next multiplier bit can come in through C.

A product (the low 32 bits, the same for signed and unsigned operands) is formed from the top of the multiplier down: clear the product, then for each multiplier bit shift it into C with add m, m and do mulstep p, b. Skipping the multiplier's leading zero bytes first makes small multipliers quick.

Data paths

Flags

V–

SWI–

EI–

S•

C–

Z•

• set; – unchanged.

Timing

Processor | Clock cycles
opc7cpu | 2 (EAD, EXEC); 3 after a store, a jump or a skipped instruction, which need a separate fetch. 1 if the predicate fails.
opc7hpcpu | 1. The result reaches the next instruction's ALU operands without a wait. An instruction that needs it earlier, as an address, store data, a jump target, a bperm source or a source with a non-zero immediate, waits up to 2 cycles. This instruction's own source is needed early in the same way when its immediate is not zero.

Examples

Instruction | Word | Effect
add r3, r3 | 08330000 | next multiplier bit (top first) to C
mulstep r1, r2 | 0F120000 | r1 ← 2 × r1 + (C ? r2 : 0)
mulstep r1, r0, 10 | 0F10000A | r1 ← 2 × r1 + (C ? 10 : 0)

NOT

Notopcode 0x05

Function

dst ← ~(src + imm16)

Format

3129p p ppred

28240 0 1 0 1opcode

2320d d d ddst

1916s s s ssrc

150i i i i i i i i i i i i i i i iimm16, sign extended

Assembler: [pred.]not dst, src[, imm]; the immediate defaults to 0. One word.

Description

The ones complement of the source plus the immediate replaces the destination register.

With an immediate of −1 this is negation, since −x = ~(x − 1).

Data paths

Flags

V–

SWI–

EI–

S•

C–

Z•

• set; – unchanged.

Timing

Processor | Clock cycles
opc7cpu | 2 (EAD, EXEC); 3 after a store, a jump or a skipped instruction, which need a separate fetch. 1 if the predicate fails.
opc7hpcpu | 1. The result reaches the next instruction's ALU operands without a wait. An instruction that needs it earlier, as an address, store data, a jump target, a bperm source or a source with a non-zero immediate, waits up to 2 cycles. This instruction's own source is needed early in the same way when its immediate is not zero.

Examples

Instruction | Word | Effect
not r1, r2 | 05120000 | r1 ← ~r2
not r3, r3, -1 | 0533FFFF | r3 ← −r3
not r4, r0 | 05400000 | r4 ← 0xFFFFFFFF

OR

Oropcode 0x04

Function

dst ← dst | (src + imm16)

Format

3129p p ppred

28240 0 1 0 0opcode

2320d d d ddst

1916s s s ssrc

150i i i i i i i i i i i i i i i iimm16, sign extended

Assembler: [pred.]or dst, src[, imm]; the immediate defaults to 0. One word.

Description

The destination register is ored with the source plus the immediate.

Data paths

Flags

V–

SWI–

EI–

S•

C–

Z•

• set; – unchanged.

Timing

Processor | Clock cycles
opc7cpu | 2 (EAD, EXEC); 3 after a store, a jump or a skipped instruction, which need a separate fetch. 1 if the predicate fails.
opc7hpcpu | 1. The result reaches the next instruction's ALU operands without a wait. An instruction that needs it earlier, as an address, store data, a jump target, a bperm source or a source with a non-zero immediate, waits up to 2 cycles. This instruction's own source is needed early in the same way when its immediate is not zero.

Examples

Instruction | Word | Effect
or r1, r2 | 04120000 | r1 ← r1 | r2
or r3, r0, 0x80 | 04300080 | set bit 7 of r3
or r4, r0 | 04400000 | test r4: S and Z from its value

OUT

Outputopcode 0x18

Function

io[src + imm16] ← dst

Format

3129p p ppred

28241 1 0 0 0opcode

2320d d d ddst

1916s s s ssrc

150i i i i i i i i i i i i i i i iimm16, sign extended

Assembler: [pred.]out dst, src[, imm]; the immediate defaults to 0. One word.

Description

The destination register is written to the I/O port at the source plus the immediate. The I/O space is separate from memory: the CPU signals the access with vio rather than vda, and the port address is 16 bits.

Any 16-bit constant is a valid port number here. The flags are unchanged.

Data paths

Flags

V–

SWI–

EI–

S–

C–

Z–

Unchanged.

Timing

Processor | Clock cycles
opc7cpu | 2 (EAD, WRM), and the next instruction then needs a separate fetch. 1 if the predicate fails.
opc7hpcpu | 1. Its address and its data register are both needed early: up to 2 cycles' wait if one of the two instructions before wrote them. It waits while a jump or anything else that could change the flow is ahead of it in the pipeline, so that it never acts and is then cancelled.

Examples

Instruction | Word | Effect
out r1, r0, 0x01 | 18100001 | write r1 to port 1 (the system UART's data)
out r2, r3, 0x10 | 18230010 | write r2 to port r3 + 16

PUTPSR

Put processor status registeropcode 0x12

Function

PSR ← src + imm16

Format

3129p p ppred

28241 0 0 1 0opcode

2320d d d ddst

1916s s s ssrc

150i i i i i i i i i i i i i i i iimm16, sign extended

Assembler: [pred.]putpsr psr, src[, imm]. One word.

Description

The source plus the immediate replaces the PSR: V from bit 31, SWI from bits 7 to 4, then EI, S, C and Z from bits 3 to 0.

A non-zero SWI value raises a software interrupt as the instruction completes. It enters the handler at 0x0002 with the return address of the next instruction. Setting EI enables hardware interrupts.

Data paths

Flags

V•

SWI•

EI•

S•

C•

Z•

• set; – unchanged. All from the operand.

Timing

Processor | Clock cycles
opc7cpu | 2 (EAD, EXEC); 3 after a store, a jump or a skipped instruction. 1 if the predicate fails.
opc7hpcpu | 1. Stores, in and out behind it wait until it completes, since it can raise a software interrupt. A software interrupt costs as a taken jump.

Examples

Instruction | Word | Effect
putpsr psr, r0, 0x08 | 12000008 | enable interrupts, clear the flags
putpsr psr, r1 | 12010000 | PSR ← r1
putpsr psr, r0, 0x18 | 12000018 | software interrupt 1, interrupts enabled

ROL

Rotate left through carryopcode 0x0E

Function

{C, dst} ← {src + imm16, C}

Format

3129p p ppred

28240 1 1 1 0opcode

2320d d d ddst

1916s s s ssrc

150i i i i i i i i i i i i i i i iimm16, sign extended

Assembler: [pred.]rol dst, src[, imm]; the immediate defaults to 0. One word.

Description

The source plus the immediate is shifted left one place. C goes into bit 0, and bit 31 goes into C.

A chain of rol instructions shifts a multi-word value left.

Data paths

Flags

V–

SWI–

EI–

S•

C•

Z•

• set; – unchanged.

Timing

Processor | Clock cycles
opc7cpu | 2 (EAD, EXEC); 3 after a store, a jump or a skipped instruction, which need a separate fetch. 1 if the predicate fails.
opc7hpcpu | 1. The result reaches the next instruction's ALU operands without a wait. An instruction that needs it earlier, as an address, store data, a jump target, a bperm source or a source with a non-zero immediate, waits up to 2 cycles. This instruction's own source is needed early in the same way when its immediate is not zero.

Examples

Instruction | Word | Effect
rol r1, r1 | 0E110000 | rotate r1 left through C
rol r2, r3 | 0E230000 | r2 ← r3 rotated left through C

ROR

Rotate right through carryopcode 0x0A

Function

{dst, C} ← {C, src + imm16}

Format

3129p p ppred

28240 1 0 1 0opcode

2320d d d ddst

1916s s s ssrc

150i i i i i i i i i i i i i i i iimm16, sign extended

Assembler: [pred.]ror dst, src[, imm]; the immediate defaults to 0. One word.

Description

The source plus the immediate is shifted right one place. C goes into bit 31, and bit 0 goes into C.

A chain of ror instructions shifts a multi-word value right.

Data paths

Flags

V–

SWI–

EI–

S•

C•

Z•

• set; – unchanged.

Timing

Processor | Clock cycles
opc7cpu | 2 (EAD, EXEC); 3 after a store, a jump or a skipped instruction, which need a separate fetch. 1 if the predicate fails.
opc7hpcpu | 1. The result reaches the next instruction's ALU operands without a wait. An instruction that needs it earlier, as an address, store data, a jump target, a bperm source or a source with a non-zero immediate, waits up to 2 cycles. This instruction's own source is needed early in the same way when its immediate is not zero.

Examples

Instruction | Word | Effect
ror r1, r1 | 0A110000 | rotate r1 right through C
ror r2, r3 | 0A230000 | r2 ← r3 rotated right through C

RTI

Return from interruptopcode 0x11

Function

pc ← saved pc; flags ← saved flags

Format

3129p p ppred

28241 0 0 0 1opcode

2320d d d ddst

1916s s s ssrc

150i i i i i i i i i i i i i i i iimm16, sign extended

Assembler: rti pc, pc. One word.

Description

Returns from an interrupt handler to the instruction where the interrupt was taken, and restores the flags saved then: V, EI, S, C and Z. The SWI bits are cleared.

Written rti pc, pc. Since EI is restored, interrupts are enabled again if they were enabled before.

Data paths

Flags

V•

SWI•

EI•

S•

C•

Z•

• set; – unchanged. Restored.

Timing

Processor | Clock cycles
opc7cpu | 2 or 3, and the target then needs a separate fetch. 1 if the predicate fails.
opc7hpcpu | 4 when the jump is taken: it is decided in EX, and the three instructions behind it are cancelled.

Examples

Instruction | Word | Effect
rti pc, pc | 11FF0000 | return from the handler

SCMP

Signed compareopcode 0x16

Function

dst − (src + imm16), with S = signed less-than

Format

3129p p ppred

28241 0 1 1 0opcode

2320d d d ddst

1916s s s ssrc

150i i i i i i i i i i i i i i i iimm16, sign extended

Assembler: [pred.]scmp dst, src[, imm]; the immediate defaults to 0. One word.

Description

Compares as cmp does, but sets S to the sign of the result exclusive-ored with V. S is then set exactly when the destination is less than the operand as signed numbers, even when the subtraction overflows.

So mi. after scmp means signed less-than, and pl. means signed greater-than-or-equal. V, C and Z are set as for cmp.

Data paths

Flags

V•

SWI–

EI–

S•

C•

Z•

• set; – unchanged. S = sign ^ V.

Timing

Processor | Clock cycles
opc7cpu | 2 (EAD, EXEC); 3 after a store, a jump or a skipped instruction. 1 if the predicate fails.
opc7hpcpu | 1. The flags are ready for a predicated instruction straight after it. Its source is needed early when the immediate is not zero.

Examples

Instruction | Word | Effect
scmp r1, r2 | 16120000 | compare r1 with r2, signed
mi.mov pc, r0, 0x400 | C0F00400 | after it: jump if r1 < r2, signed
scmp r1, r0, -5 | 1610FFFB | compare r1 with −5, signed

STO

Storeopcode 0x1A

Function

mem[src + imm16] ← dst

Format

3129p p ppred

28241 1 0 1 0opcode

2320d d d ddst

1916s s s ssrc

150i i i i i i i i i i i i i i i iimm16, sign extended

Assembler: [pred.]sto dst, src[, imm]; the immediate defaults to 0. One word.

Description

The destination register is written to memory at the source plus the immediate, a word address of which the low 20 bits are used. The flags are unchanged.

Note that the register written to memory is the one in the destination field.

Data paths

Flags

V–

SWI–

EI–

S–

C–

Z–

Unchanged.

Timing

Processor | Clock cycles
opc7cpu | 2 (EAD, WRM), and the next instruction then needs a separate fetch. 1 if the predicate fails.
opc7hpcpu | 1. Its address and its data register are both needed early: up to 2 cycles' wait if one of the two instructions before wrote them. It waits while a jump or anything else that could change the flow is ahead of it in the pipeline, so that it never acts and is then cancelled.

Examples

Instruction | Word | Effect
sto r1, r2 | 1A120000 | mem[r2] ← r1
sto r1, r11, 3 | 1A1B0003 | mem[r11 + 3] ← r1
sto r0, r0, 0x200 | 1A000200 | mem[0x200] ← 0

SUB

Subtractopcode 0x07

Function

{C, dst} ← dst + ~(src + imm16) + 1

Format

3129p p ppred

28240 0 1 1 1opcode

2320d d d ddst

1916s s s ssrc

150i i i i i i i i i i i i i i i iimm16, sign extended

Assembler: [pred.]sub dst, src[, imm]; the immediate defaults to 0. One word.

Description

The source plus the immediate is subtracted from the destination register.

C is set when there is no borrow, that is when the destination was greater than or equal to the operand as unsigned numbers. V is set on signed overflow.

Data paths

Flags

V•

SWI–

EI–

S•

C•

Z•

• set; – unchanged.

Timing

Processor | Clock cycles
opc7cpu | 2 (EAD, EXEC); 3 after a store, a jump or a skipped instruction, which need a separate fetch. 1 if the predicate fails.
opc7hpcpu | 1. The result reaches the next instruction's ALU operands without a wait. An instruction that needs it earlier, as an address, store data, a jump target, a bperm source or a source with a non-zero immediate, waits up to 2 cycles. This instruction's own source is needed early in the same way when its immediate is not zero.

Examples

Instruction | Word | Effect
sub r1, r2 | 07120000 | r1 ← r1 − r2
sub r3, r0, 1 | 07300001 | r3 ← r3 − 1, Z set at zero
sub r4, r4 | 07440000 | r4 ← 0, C set

XOR

Exclusive oropcode 0x02

Function

dst ← dst ^ (src + imm16)

Format

3129p p ppred

28240 0 0 1 0opcode

2320d d d ddst

1916s s s ssrc

150i i i i i i i i i i i i i i i iimm16, sign extended

Assembler: [pred.]xor dst, src[, imm]; the immediate defaults to 0. One word.

Description

The destination register is exclusive-ored with the source plus the immediate.

Data paths

Flags

V–

SWI–

EI–

S•

C–

Z•

• set; – unchanged.

Timing

Processor | Clock cycles
opc7cpu | 2 (EAD, EXEC); 3 after a store, a jump or a skipped instruction, which need a separate fetch. 1 if the predicate fails.
opc7hpcpu | 1. The result reaches the next instruction's ALU operands without a wait. An instruction that needs it earlier, as an address, store data, a jump target, a bperm source or a source with a non-zero immediate, waits up to 2 cycles. This instruction's own source is needed early in the same way when its immediate is not zero.

Examples

Instruction | Word | Effect
xor r1, r2 | 02120000 | r1 ← r1 ^ r2
xor r3, r0, -1 | 0230FFFF | invert every bit of r3
xor r4, r4 | 02440000 | r4 ← 0, Z set
