revaldinho/opc/opc7hp/synthesis/tangnano20k/results.txt

date             cpu    version       LOGIC LOGIC%   LUT4   ALU  MUX2   DFF RAM16 BSRAM    DSP Fmax MHz min/med/max  note
2026-10-26 21:28 opc7   93b4cdb        1666   8.0%   1576    90   858   153    16     8      0       91.3/94.1/97.2  baseline, before any SIAL work
2026-10-26 23:26 opc7   93b4cdb        1684   8.1%   1594    90   895   153    16     8      0    100.9/103.2/106.6  synth_gowin -family gw2a (earlier lines: gw1n default)
2026-10-27 21:26 opc7   73190b5        2065  10.0%   1975    90  1276   153    16     8      0     90.5/100.3/103.6  with scmp (opcode 0x16)
2026-10-30 20:25 opc7   73190b5        1624   7.8%   1534    90   818   153    16     8      0       75.3/78.3/81.6  with scmp; yosys 0.70 Release, nextpnr 0.11.1-84
2026-10-30 20:25 opc7   md5:2d3e348    1589   7.7%   1499    90   777   153    16     8      0       77.4/78.1/78.5  93b4cdb, before scmp; yosys 0.70 Release, nextpnr 0.11.1-84
2026-10-30 20:25 opc7   md5:54f452a    1597   7.7%   1507    90   770   153    16     8      0      95.6/97.3/101.1  73190b5 with PRED_IN_EAD_ONLY; yosys 0.70 Release, nextpnr 0.11.1-84
2026-10-30 21:01 opc7h  md5:1af0f76    1822   8.8%   1732    90   918   200    16    16      0       84.2/86.3/86.7  opc7h: separate instruction port, dual-port BSRAM; yosys 0.70 Release, nextpnr 0.11.1-84
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
2026-11-11 23:52 opc7hp b680f93+       1191   5.7%   1087   104     0   413    16     8      0    112.6/112.8/121.9  [-nowidelut] rti restores V
2026-11-11 23:52 opc7   49508f5+       1780   8.6%   1690    90   968   154    16     8      0       73.6/76.4/81.9  rti restores V
2026-11-13 17:49 opc7hp 834d013        1333   6.4%   1193   140     0   416    16     8      0    104.5/109.9/112.0  [-nowidelut] mulstep, divstep
2026-11-13 17:49 opc7   834d013        1879   9.1%   1721   158   902   154    16     8      0       68.7/72.9/73.6  mulstep, divstep
