revaldinho/opc/opc7/claude-tests/README

Tests for sial2opc.py and the OPC bcpllib written while fixing them (October 2026).

Each .b test prints results that are compared with the output of the same
program run natively under cintsys; the native output is in <name>.expected.
The emulator runs under pypy3 with -q (no trace) by default; use
'make TRACE=1 <name>.emu.stdout' to keep the full trace in <name>.trace,
and 'make DUMP=1 <name>.emu.stdout' for the emulator's memory dump in
<name>.emu.dump (the Verilog testbench writes its own to <name>.dump).

  cmptest.b     Signed comparisons, as values (LET t = a<b) and as conditional
                jumps (TEST a<b), for every pair of 11 edge values including
                32767/-32768, where a 16 bit subtraction overflows. Also constant
                shifts that the -o optimiser rewrites. Use on OPC6 and OPC7.
  optest.b      Opcodes added 23/10/2026: ikl (STATIC +:=), goto (computed
                GOTO), selld/selst/xselst (SLCT field selectors within 16 bits).
                Prints low 16 bits only, so use on OPC6 and OPC7.
  optest32.b    32 bit selector fields and large ikl constants, which need the
                large constant register r8. OPC7 only.
  divtest.b     / and MOD for dividends of every byte length (just below and
                above each byte boundary, zero, maxint, minint) by small and
                large divisors of both signs, for the OPC7 divide routine that
                skips leading zero bytes (25/10/2026). OPC7 only.
  bittest.b     bcpllib setbit/testbit (25/10/2026: a shift and a mask instead
                of / and MOD): set and clear bits 0-319, checking the old
                state and testbit, then a bit vector
                sieve to 20000 that also serves as a benchmark. OPC7 only, as
                bitsperword is 32 in bcpllib.
  p2divtest.b   / and MOD by constant powers of 2 (2**0 to 2**14), which
                sial2opc.py -o translates inline as shifts and a mask
                (25/10/2026), for 16 bit dividends including negative ones
                (/ truncates towards zero, MOD takes the dividend's sign).
                Both SIAL forms, l Kn and atbl Kn before div/mod, with one
                writef per divisor. Use on OPC6 and OPC7.
  p2div32test.b The same for 32 bit dividends and divisors up to 2**23, where
                the constants need the large constant register r8. OPC7 only.
  xdivtest.b    The reversed SIAL operations xdiv (a := a / b) and xmod
                (a := a MOD b), which the compiler generates after comparing
                the operands or for one call result divided by another, as in
                bcpltests/modarith.b and eval.b; OPC7 calls __xdiv and __xmod
                (25/10/2026). Signed values including minint and maxint, and
                an xmod as a byte index. OPC7 only.
  shifttest.b   Shifts by a variable distance (25/10/2026: whole bytes with
                bperm in a syslib routine, then a jump into a run of single
                shifts) for every distance from -33 to 40 in both directions:
                32 or more gives 0, a negative distance shifts the other way.
                Also some constant shifts. OPC7 only.
  writefmt.b    writef formats in the OPC bcpllib (extended 23/10/2026): widths
                before the letter (%11i), after it (%i5, %ib), %d and %n.mD
                fixed point. Use on OPC6 and OPC7.
  Sort programs from the BCPL distribution (copied from ../bcpltests/sort),
  OPC7 only, run by 'make check-sort' (a few minutes):
    shell23.b sortdemo.b heapsort.b mrsort2.b nqsort.b pesort.b heapqsort.b
                Larger runs (up to 100,000 words) of the same opcodes. Their data
                comes from randno, which in the OPC bcpllib is the native generator,
                so their .expected files are plain native runs ('make sort-expected'
                regenerates them). Blank lines and heapsort's "Sorting complete in
                N msecs" timings are ignored.
  randtest.b    randno/setseed (the native generator since 24/10/2026), unseeded
                (start seed 12345 as in cintsys) and seeded; must equal a plain
                native run. OPC7 only.
  rand16.b      The 16 bit form of the same generator on OPC6; rand16.expected
                comes from a model of it, as there is no native 16 bit system.
                OPC6 only.
  flt.b         Uses floating point; sial2opc.py must stop with an error
                (exit status 1) naming the unsupported opcode.
  jge0m_mlab_nop.sial
                Hand-written SIAL for jge0m, mlab and nop, which the current
                compiler no longer generates. Check the translation by eye:
                  python3 ../../bcpl/sial2opc.py --opc7 -n -f jge0m_mlab_nop.sial -g ../../bcpl/ext_sial.h

Running the tests, with the BCPL environment variables set:

  make                 all tests on OPC7, printing PASS/FAIL for each
  make ARCH=opc6       the tests that fit in 16 bits, on OPC6
  make check-all       clean, OPC6, clean, OPC7 including the sort programs
                       (outputs share file names, so run 'make clean' when
                       switching ARCH by hand)
  make check-sort      only the sort programs (OPC7)
  make sort-expected   regenerate the sort programs' .expected files
  make clean

make exits non-zero if any test fails.

The steps make runs for one test (here optest on OPC7; use 6 for OPC6):

  cintsys -c bcpl2sial optest.b to optest.sial
  python3 ../../bcpl/sial2opc.py --opc7 -f optest.sial -f ../bcpltests/bcpllib.sial \
      -s ../../bcpl/opc7_syslib.s -g ../../bcpl/ext_sial.h -o > optest.tmp.s
  cat ../../include/opc7/macros.s optest.tmp.s ../../bcpl/opc7_rom.s > optest.s
  python3 ../opc7asm.py optest.s optest.hex > optest.lst
  python3 ../opc7emu.py optest.hex optest.dump | grep OUT | ../../utils/show_stdout.py --opc7 > optest.out
  diff optest.expected optest.out

For OPC6 use ../../opc6/opc6asm.py and ../../opc6/opc6emu.py, the opc6 syslib,
rom and macros, and --opc6 for show_stdout.py.

Note: write a comparison as a separate LET (LET t = a<b) to get the value
opcodes; the multiple form LET t1, t2 = a<b, a>b compiles to jumps.
