revaldinho/opc/system/blackice/opc7/test_data.txt

S1231000ED2801104F000D19EEFF01106B000D19EEFF011020000D19EEFF0D1960100210C9
S12310200600031015003600140025000B003100120021000D196B10190001100A001B00B0
S1231040211792100D196B1091041B00210011041110FFFF0D197810211692102210FFFF55
S12310600F70191001100A000D1978100116931052004100B300033A0A000FB042100300A0
S123108011100100023A05000FB04C100F704E100D19EEFF01102E000D19EEFF3100011347
S12310A030006300023A05000F9058103310FDFF2210FFFF0F7013100D19EEFFED29DF0038
S12310C00110020002101500211692102210FFFF0F706410DF001A00031010001104BB04E6
S12310E00FB07310A1043310FFFF0F706E10DF001A000310100001100000BB041105A12AFA
S12311000FB08310A10BBB053310FFFF0F707E10DF000000000000000000000000000000E0
