revaldinho/opc/opc7/opc7cpu.v

module opc7cpu(input[31:0] din,input clk,input reset_b,input[1:0] int_b,input clken,output vpa,output vda,output vio,output[31:0] dout,output[19:0] address,output rnw);
  parameter MOV=5'h0,MOVT=5'h1,XOR=5'h2,AND=5'h3,OR=5'h4,NOT=5'h5,CMP=5'h6,SUB=5'h7,ADD=5'h8,BPERM=5'h9,ROR=5'hA,LSR=5'hB,JSR=5'hC,ASR=5'hD,ROL=5'hE,MULSTEP=5'hF;
  parameter HLT=5'h10,RTI=5'h11,PPSR=5'h12,GPSR=5'h13,SCMP=5'h16,DIVSTEP=5'h17,OUT=5'h18,IN=5'h19,STO=5'h1A,LD=5'h1B,LJSR=5'h1C,LMOV=5'h1D,LSTO=5'h1E,LLD=5'h1F;
  parameter FET=3'h0,EAD=3'h1,RDM=3'h2,EXEC=3'h3,WRM=3'h4,INT=3'h5,V=31,EI=3,S=2,C=1,Z=0,INT_VECTOR0=20'h2,INT_VECTOR1=20'h4;
  parameter P2=29,P1=30,P0=31;
  reg [19:0]  addr_d, PC_q,PC_d,PCI_q,PCI_d;(* RAM_STYLE="DISTRIBUTED" *)
  reg [31:0]  PSR_d,PSR_q,RF_q[14:0], RF_pipe_q, RF_pipe_d, OR_q, OR_d, result;
  reg [4:0]   IR_q, IR_d;
  reg [3:0]   swiid,dst_q,dst_d,src_q,src_d;
  reg [4:0]   PSRI_q,PSRI_d;                    // flags saved on an interrupt: V, EI, S, C, Z
  reg [2:0]   FSM_q, FSM_d;
  reg         overflow,zero,carry,sign,enable_int,reset_s0_b,reset_s1_b,subnotadd_q,rnw_q, rnw_d,vpa_q, vpa_d, vda_q, vda_d, vio_q, vio_d;
`ifdef PRED_IN_EAD_ONLY  
  wire        pred       = (OR_q[29] ^ (OR_q[30]?(OR_q[31]?PSR_q[S]:PSR_q[Z]):(OR_q[31]?PSR_q[C]:1)));
`else  
  wire        pred_d     = (din[P2] ^ (din[P1] ? (din[P0] ? sign : zero): (din[P0] ? carry : 1))); // New data,new flags (in exec/fetch)
  wire        pred_din   = (din[P2] ^ (din[P1]?(din[P0]?PSR_q[S]:PSR_q[Z]):(din[P0]?PSR_q[C]:1))); // New data,old flags (in fetch0)
`endif  
  wire [31:0] RF_sout    = {32{(|src_q)&&IR_q[4:2]!=3'b111}} & ((src_q==4'hF)? {12'b0,PC_q} : RF_q[src_q]);
  wire [7:0]  bytes0     = {8{~OR_q[2] }} & ((OR_q[1])?  ((OR_q[0]) ?RF_sout[31:24] :RF_sout[23:16]):(OR_q[0]) ? RF_sout[15:8]:RF_sout[7:0]);
  wire [7:0]  bytes1     = {8{~OR_q[6] }} & ((OR_q[5])?  ((OR_q[4]) ?RF_sout[31:24] :RF_sout[23:16]):(OR_q[4]) ? RF_sout[15:8]:RF_sout[7:0]);
  wire [7:0]  bytes2     = {8{~OR_q[10]}} & ((OR_q[9])?  ((OR_q[8]) ?RF_sout[31:24] :RF_sout[23:16]):(OR_q[8]) ? RF_sout[15:8]:RF_sout[7:0]);
  wire [7:0]  bytes3     = {8{~OR_q[14]}} & ((OR_q[13])? ((OR_q[12])?RF_sout[31:24] :RF_sout[23:16]):(OR_q[12])? RF_sout[15:8]:RF_sout[7:0]);
  wire [33:0] dstep      = {1'b0, RF_pipe_q, PSR_q[C]} - {2'b0, OR_q};     // DIVSTEP: {rd,C} - op, the borrow in bit 33
  wire [31:0] din_sxt    = (IR_q[4:2]==3'h7)? {{12{OR_q[19]}},OR_q[19:0]} : {{16{OR_q[15]}}, OR_q[15:0]};
  assign {rnw,dout,address} = {rnw_d, RF_pipe_d, addr_d};
  assign {vpa,vda,vio}   = {vpa_d, vda_d, vio_d };
  always @( * ) begin
    case (IR_q)
      AND,OR           :{carry,result} = {PSR_q[C],(IR_q==AND)?(RF_pipe_q & OR_q):(RF_pipe_q | OR_q)};
      MOVT,ROL         :{carry,result} = (IR_q==ROL)? {OR_q, PSR_q[C]} :{PSR_q[C], OR_q[15:0], RF_pipe_q[15:0]} ;
      ADD,SUB,CMP,SCMP :{carry,result} = RF_pipe_q + OR_q + subnotadd_q; // OR_q negated in EAD if required for sub/cmp
      XOR,GPSR         :{carry,result} = (IR_q==GPSR)?{PSR_q[C],PSR_q}:{PSR_q[C],RF_pipe_q ^ OR_q};
      NOT              :{result,carry} = {~OR_q,PSR_q[C]};
      ROR,ASR,LSR      :{result,carry} = {(IR_q==ROR)?PSR_q[C]:(IR_q==ASR)?OR_q[31]:1'b0,OR_q};
      JSR,LJSR         :{result,carry} = { 12'b0, PC_q, PSR_q[C]};
      MULSTEP          :{carry,result} = {PSR_q[C], {RF_pipe_q[30:0],1'b0} + (OR_q & {32{PSR_q[C]}})}; // rd<<1 + (C ? op : 0)
      DIVSTEP          :{carry,result} = (dstep[33]) ? {1'b0, RF_pipe_q[30:0], PSR_q[C]} : {1'b1, dstep[31:0]}; // {rd,C} less op if >= op
      default          :{carry,result} = {PSR_q[C],OR_q} ;
    endcase // case ( IR_q )
    overflow = (IR_q==PPSR)? OR_q[31]: ((IR_q==ADD||IR_q==SUB||IR_q==CMP||IR_q==SCMP)&&(dst_q!=4'hF))?((RF_pipe_q[31]&OR_q[31]&(~result[31]))|((~RF_pipe_q[31])&(~OR_q[31])&result[31])):PSR_q[V];
    {swiid,enable_int,sign,carry,zero} = (IR_q==PPSR)?OR_q[7:0]:(dst_q!=4'hF)?{PSR_q[7:3],(result[31]^((IR_q==SCMP)&overflow)),carry,!(|result)}:PSR_q;
  end
  always @( * ) begin
    if (!reset_s1_b) FSM_d=FET;
    else
      case (FSM_q)
`ifdef PRED_IN_EAD_ONLY        
        FET    : FSM_d = EAD ;
        EAD    : FSM_d = (!pred) ? FET : (IR_q==LD||IR_q==LLD||IR_q==IN) ? RDM : (IR_q==STO||IR_q==LSTO||IR_q==OUT) ? WRM : EXEC;
        EXEC   : FSM_d = ((!(&int_b) & PSR_q[EI])||(IR_q==PPSR&&(|swiid)))?INT:(dst_q==4'hF||IR_q==JSR||IR_q==LJSR)?FET: EAD;
`else
        FET    : FSM_d = (!pred_din) ? FET : EAD ;
        EAD    : FSM_d = (IR_q==LD||IR_q==LLD||IR_q==IN) ? RDM : (IR_q==STO||IR_q==LSTO||IR_q==OUT) ? WRM : EXEC;        
        EXEC   : FSM_d = ((!(&int_b) & PSR_q[EI])||(IR_q==PPSR&&(|swiid)))?INT:(dst_q==4'hF||IR_q==JSR||IR_q==LJSR)?FET:  (pred_d) ? EAD: FET;
`endif        
        WRM    : FSM_d = (!(&int_b) & PSR_q[EI])?INT:FET;
        default: FSM_d = (FSM_q==RDM)? EXEC : FET;
      endcase
  end
  always @( * ) begin
    if ( !reset_s1_b) begin
      {rnw_d, vpa_d} = 2'b11;
      {vda_d, vio_d, PC_d, PCI_d, PSRI_d, PSR_d, IR_d, dst_d, src_d, RF_pipe_d, OR_d, addr_d} = 0;
    end
    else begin
      {rnw_d, vpa_d} = {!(FSM_d==WRM),(FSM_d==FET||FSM_d==EXEC)};
      {vda_d, vio_d} = {({2{FSM_d==RDM||FSM_d==WRM}}&{!(IR_q==IN||IR_q==OUT),IR_q==IN||IR_q==OUT})};
      {PC_d, PCI_d, PSRI_d, PSR_d, IR_d, dst_d, src_d} = {PC_q, PCI_q, PSRI_q, PSR_q, IR_q, dst_q, src_q};
      RF_pipe_d = (dst_q==4'hF)? {12'b0,PC_q} : RF_q[dst_q] & {32{(|dst_q)}};
      OR_d  = (FSM_q==EAD)? (IR_q==BPERM)?({bytes3,bytes2,bytes1,bytes0}):(RF_sout+din_sxt) ^ {32{IR_q==SUB||IR_q==CMP||IR_q==SCMP}} : din;
      if ((FSM_q==FET)||(FSM_q==EXEC)) begin
        {IR_d, dst_d, src_d} = din[28:16] ;
        if (FSM_q==FET)
          PC_d  = PC_q + 1;
        else if ( FSM_q == EXEC) begin
          PC_d = (IR_q==RTI)?PCI_q: (dst_q==4'hF) ? result[19:0] : (IR_q==JSR||IR_q==LJSR)? OR_q[19:0]:((!(&int_b)&&PSR_q[EI])||(IR_q==PPSR&&(|swiid)))?PC_q:PC_q + 1;
          PSR_d = (IR_q==RTI)?{PSRI_q[4],27'b0,PSRI_q[3:0]}:{overflow,23'b0,swiid,enable_int,sign,carry,zero};
        end
      end
      else if (FSM_q==EAD & (IR_q==CMP || IR_q==SCMP) )
        dst_d = 4'b0; // Zero dest addr after reading it in EAD for CMP operations
      else if ( FSM_q == INT )
        {PC_d,PCI_d,PSRI_d,PSR_d[EI]} = {(!int_b[1])?INT_VECTOR1:INT_VECTOR0,PC_q,PSR_q[V],PSR_q[3:0],1'b0};

      addr_d = (vpa_d)? PC_d : RF_sout+din_sxt;
    end
  end
  always @(posedge clk)
    if (clken) begin
      {RF_pipe_q, OR_q, PC_q, PCI_q, PSRI_q, PSR_q} <= {RF_pipe_d, OR_d, PC_d, PCI_d, PSRI_d, PSR_d};
      {reset_s0_b,reset_s1_b, subnotadd_q} <= {reset_b, reset_s0_b, IR_q!=ADD};
      {FSM_q, vda_q, vpa_q, vio_q, rnw_q, IR_q, dst_q, src_q} <= {FSM_d, vda_d, vpa_d, vio_d, rnw_d, IR_d, dst_d, src_d};
      if ( FSM_q == EXEC) begin
        RF_q[dst_q] <= result;
      end
    end
endmodule
