revaldinho/opc/opc7/opc7emu.py

import sys, re, functools
# -q: quiet mode, no per-instruction trace (memory and I/O accesses are still printed)
trace = "-q" not in sys.argv
sys.argv = [a for a in sys.argv if a != "-q"]
mnemonics="mov movt xor and or not cmp sub add bperm ror lsr jsr asr rol mulstep halt rti putpsr getpsr s14 s15 scmp divstep out in sto ld ljsr lmov lsto lld".split()
op = dict([(opcode,mnemonics.index(opcode)) for opcode in mnemonics])
dis = dict([(mnemonics.index(opcode),opcode) for opcode in mnemonics])
pred_dict = {0:"",1:"0.",2:"z.",3:"nz.",4:"c.",5:"nc.",6:"mi.",7:"pl."}
def print_memory_access( type, address, data):
    ch = '%s' % chr(data) if ( 0x1F < data < 0x7F) else ' '
    print( "%6s :  Address : 0x%08x (%6d)       :        Data : 0x%08x (%10d) %s" % (type,address&(0xFFFFF if type not in ("IN","OUT") else 0xFFFF),address&(0xFFFFF if type not in ("IN","OUT") else 0xFFFF),data,data,ch))

if len(sys.argv) > 3:
    with open(sys.argv[3],"r") as f:
        input_text = iter(''.join(f.readlines()))
else:
    input_text = iter([chr(0)]*100000)

(wordmem, adr) = ([0]*0x100000, 0)
for x in open(sys.argv[1]).read().split():  # $readmemh format: hex words, '@addr' sets the load address
    if x[0] == '@': adr = int(x[1:],16)
    else: (wordmem[adr], adr) = (int(x,16) & 0xFFFFFFFF, adr+1)
(regfile, v, acc, c, z, pcreg, c_save, s, ei, swiid, interrupt, iomem) = ([0]*16,0,0,0,0,15,0,0,0,0,0, [0]*65536)
if trace: print ("PC     : Mem      : Instruction            : V SWI I S C Z : %s\n%s" % (''.join(["  r%2d    " % d for d in range(0,16)]), '-'*202))
while True:
    (pc_save,flag_save,regfile[0]) = (regfile[pcreg],(v,swiid,ei,s,c,z),0)    # always overwrite r0 and then dont care about assignments
    instr_word = wordmem[regfile[pcreg] & 0xFFFFF] &  0xFFFFFFFF
    (p0, p1, p2) = ( (instr_word >> 31) & 1, (instr_word >> 30) & 1, (instr_word >> 29 ) & 1)
    (opcode, dest, source) = (((instr_word >> 24) & 0x1F), (instr_word>>20)&0xF , (instr_word>>16) & 0xF)
    (operand, source) = (instr_word & 0xFFFFF, 0x0) if (0x1C<=opcode<=0x1F) else ( instr_word & 0xFFFF, source)

    # sign extend operand !
    if (0x1C<=opcode<=0x1F):
        operand = (operand | 0xFFF00000)  if (operand & 0x80000 != 0) else operand
    else:
        operand = (operand | 0xFFFF0000)  if (operand & 0x8000 != 0) else operand

    if trace: instr_str = "%s%s r%d,r%d,0x%05X" % ((pred_dict[p0<<2 | p1<<1 | p2] ),dis[opcode],dest,source,(operand & 0xFFFFF))
    if trace: instr_str = re.sub("r0","psr",instr_str,1) if (opcode in (op["putpsr"],op["getpsr"])) else instr_str

    regfile[pcreg] += 1
    if ( opcode==op["bperm"]):
        ea_ed = eff_addr = regfile[source]
    else:
        eff_addr = (regfile[source] + operand)&0xFFFFFFFF  # EA_ED must be computed after PC is brought up to date
        ea_ed = wordmem[eff_addr & 0xFFFFF] if (opcode in(op["ld"],op["lld"])) else iomem[eff_addr&0xFFFF] if (opcode in(op["ld"],op["in"],op["lld"])) else eff_addr

    if opcode == op["in"]:
        try:
            ea_ed = ord(input_text.__next__())
        except:
            ea_ed = 0
    if interrupt : # software interrupts dont care about EI bit
        (interrupt, regfile[pcreg], pc_int, psr_int , ei) = (0, 0x00000002, pc_save, (v,swiid,ei,s,c,z), 0)
    else:
        if trace: print ("%08x : %08X : %-22s : %d  %1X  %d %d %d %d : " % (pc_save, instr_word, instr_str, v, swiid ,ei, s, c, z), end='')
        if trace: print (' '.join(["%08X" % r for r in regfile ]))
        if (bool(p2) ^ (bool(s if p0==1 else z) if p1==1 else bool(c if p0==1 else 1))):
            if opcode == (op["halt"]):
                print("Stopped on halt instruction at %08x with halt number 0x%04x" % (regfile[pcreg], operand) )
                break
            elif opcode == op["rti"]:
                (regfile[pcreg], flag_save) = (pc_int, (psr_int[0],0,psr_int[2],psr_int[3],psr_int[4],psr_int[5]) )
            elif opcode ==op["and"]:
                regfile[dest] = (regfile[dest] & ea_ed) & 0xFFFFFFFF
            elif opcode == op["or"]:
                regfile[dest] = (regfile[dest] | ea_ed) & 0xFFFFFFFF
            elif opcode == op["xor"]:
                regfile[dest] = (regfile[dest] ^ ea_ed) & 0xFFFFFFFF
            elif opcode in (op["ror"],op["asr"],op["lsr"]):
                (c, regfile[dest]) = (ea_ed & 0x1, ( ((c<<31) if opcode==op["ror"] else (ea_ed&0x80000000 if opcode==op["asr"] else 0)) | ((ea_ed&0xFFFFFFFF) >> 1)))
            elif opcode == op["rol"]:
                (c, regfile[dest]) = ( (ea_ed>>31)&1, ((ea_ed<<1)&0xFFFFFFFE) | c)
            elif opcode == op["add"] :
                res = (regfile[dest] + ea_ed & 0x1FFFFFFFF)
                v = 1 if  ((((~res)&ea_ed&regfile[dest])|((res)&(~ea_ed)&(~regfile[dest])))&0x80000000)!=0 else 0                
                (c, regfile[dest])  = ( (res>>32) & 1, res & 0xFFFFFFFF)
            elif opcode == op["mulstep"]:        # rd := rd<<1 + (C ? op : 0); C kept (added 13/11/2026)
                regfile[dest] = ((regfile[dest] << 1) + (ea_ed if c else 0)) & 0xFFFFFFFF
            elif opcode == op["divstep"]:        # t := rd<<1 | C (33 bits); t >= op: rd := t - op, C := 1; else rd := t, C := 0
                t = (regfile[dest] << 1) | c
                (c, regfile[dest]) = (1, (t - (ea_ed & 0xFFFFFFFF)) & 0xFFFFFFFF) if t >= (ea_ed & 0xFFFFFFFF) else (0, t & 0xFFFFFFFF)
            elif opcode == op["not"]:
                regfile[dest] = (~ea_ed) & 0xFFFFFFFF
            elif opcode == op["movt"]:
                regfile[dest] = ((ea_ed<<16) & 0xFFFF0000) | (regfile[dest]&0x0FFFF)
            elif opcode in (op["mov"], op["lmov"], op["ld"], op["in"], op["lld"]):
                regfile[dest] = ea_ed & 0xFFFFFFFF
                if opcode in (op["ld"],op["in"],op["lld"]):
                    print_memory_access( "IN" if opcode==op["in"] else "LOAD" , eff_addr, ea_ed)
            elif opcode in (op["sub"], op["cmp"], op["scmp"]) :
                nea = (~ea_ed)&0xFFFFFFFF               # invert, add with carry in, as the hardware
                res = (regfile[dest] + nea + 1) & 0x1FFFFFFFF
                v = 1 if ((((~res)&nea&regfile[dest])|(res&(~nea)&(~regfile[dest])))&0x80000000)!=0 else 0                
                dest = 0 if (opcode in (op["cmp"], op["scmp"])) else dest #  update dest reg to be r0 for correct flag setting later if PC was compared                
                (c, regfile[dest])  = ( (res>>32) & 1, res & 0xFFFFFFFF)
            elif opcode in (op["jsr"], op["ljsr"]):
                (preserve_flag,regfile[dest],regfile[pcreg]) = (True,regfile[pcreg],ea_ed)
            elif opcode == op["bperm"]:
                n = [ (operand>>i)&0xF for i in range(0,16,4) ]
                bytes = [ 0 if (8>i>3) else ((ea_ed>>(n[i]*8))&0xFF) for i in range(0,5)]
                regfile[dest] = functools.reduce( lambda x,y: x|y, [ y<<x for (y,x) in zip(bytes,range(0,32,8))])
            elif opcode == op["putpsr"]:
                (flag_save, interrupt) = (((ea_ed&0x80000000)>>31,(ea_ed&0xF0)>>4,(ea_ed&0x8)>>3,(ea_ed&0x4)>>2,(ea_ed&0x2)>>1,(ea_ed)&1), (ea_ed&0xF0)!=0)
            elif opcode == op["getpsr"]:
                regfile[dest] = ((v<<31)&0x80000000)| ((swiid&0xF)<<4) | (ei<<3) | (s<<2) | (c<<1) | z
            elif opcode in (op["sto"],op["lsto"]):
                wordmem[ea_ed&0xFFFFF] = regfile[dest]
                print_memory_access("STORE",ea_ed,regfile[dest])
            elif opcode == op["out"]:
                iomem[ea_ed&0xFFFF] = regfile[dest]
                print_memory_access("OUT",ea_ed,regfile[dest])
            if  (dest==pcreg) or opcode in (op["sto"],op["out"],op["lsto"],op["putpsr"], op["rti"]):
                (v,swiid,ei,s,c,z) = flag_save
            else:
                (v, swiid,ei,s,c,z) = (v, swiid,ei,((regfile[dest]>>31) & 1)^(v if opcode==op["scmp"] else 0), c, 1 if (regfile[dest]==0) else 0)
if len(sys.argv) > 2 and sys.argv[2] != "-":  # Dump memory for inspection if required ('-' for no dump)
    with open(sys.argv[2],"w" ) as f:
        f.write( '\n'.join([''.join("%08x " % d for d in wordmem[j:j+12]) for j in [i for i in range(0,len(wordmem),12)]]))
