revaldinho/opc/copro/src/Tube/hp_bytequad.v

//**************************************************************************
//    hp_bytequad.v - wrapper for 4 FIFOs in the host to parasite direction.
//   
//    COPYRIGHT 2010 Richard Evans, Ed Spittles
// 
//    This file is part of tube - an Acorn Tube ULA compatible system.
//   
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
// ============================================================================
`timescale 1ns / 1ns

module hp_bytequad (
                  input h_rst_b,
                  input h_we_b,
                  input [3:0] h_selectData,
                  input h_phi2,
                  input [7:0] h_data,                  
                  input [3:0] p_selectData,
                  input p_phi2,
                  input p_rdnw,
                  input one_byte_mode,
                  output [7:0] p_data,
                  output [3:0] p_data_available,
                  output p_r3_two_bytes_available,
                  output [3:0] h_full
                  );

   // Declare registers and wires
   reg [7:0]  p_datamux_r;        
   wire [3:0] h_full_pre_w;
   wire [7:0] fifo0_w,
              fifo1_w,
              fifo2_w,
              fifo3_w;   

   
   // assign primary IOs
   assign p_data = p_datamux_r;   
   assign h_full = h_full_pre_w;

   // Combinatorial code for the data output
   always @ (fifo0_w or
             fifo1_w or
             fifo2_w or
             fifo3_w or
             p_selectData
             )
     casex (p_selectData)
       4'bxxx1: p_datamux_r = fifo0_w;
       4'bxx1x: p_datamux_r = fifo1_w;
       4'bx1xx: p_datamux_r = fifo2_w;
       4'b1xxx: p_datamux_r = fifo3_w;
       default: p_datamux_r = 8'bx;
     endcase // case p_selectData
   

   // module instances
   hp_byte    reg1 (
                    .h_rst_b(h_rst_b),
                    .h_we_b(h_we_b),
                    .h_selectData(h_selectData[0]),
                    .h_phi2(h_phi2),
                    .h_data(h_data),
                    .p_selectData(p_selectData[0]),
                    .p_phi2(p_phi2),
                    .p_rdnw(p_rdnw),
                    .p_data(fifo0_w),
                    .p_data_available(p_data_available[0]),
                    .h_full(h_full_pre_w[0])
                    );
   
   hp_byte    reg2 (
                    .h_rst_b(h_rst_b),
                    .h_we_b(h_we_b),
                    .h_selectData(h_selectData[1]),
                    .h_phi2(h_phi2),
                    .h_data(h_data),
                    .p_selectData(p_selectData[1]),
                    .p_phi2(p_phi2),
                    .p_rdnw(p_rdnw),
                    .p_data(fifo1_w),
                    .p_data_available(p_data_available[1]),
                    .h_full(h_full_pre_w[1])
                    );

   hp_reg3 reg3 (
                 .h_rst_b(h_rst_b),
                 .h_we_b(h_we_b),
                 .h_selectData( h_selectData[2]),
                 .h_phi2(h_phi2),
                 .h_data( h_data ),                 
                 .p_selectData( p_selectData[2]),
                 .p_phi2(p_phi2),
                 .p_rdnw(p_rdnw), 
                 .one_byte_mode(one_byte_mode),
                 .p_data(fifo2_w),
                 .p_data_available(p_data_available[2]),
                 .p_two_bytes_available( p_r3_two_bytes_available),
                 .h_full(h_full_pre_w[2])
                 );

   hp_byte    reg4 (
                    .h_rst_b(h_rst_b),
                    .h_we_b(h_we_b),
                    .h_selectData(h_selectData[3]),
                    .h_phi2(h_phi2),
                    .h_data(h_data),
                    .p_selectData(p_selectData[3]),
                    .p_phi2(p_phi2),
                    .p_rdnw(p_rdnw),
                    .p_data(fifo3_w),
                    .p_data_available(p_data_available[3]),
                    .h_full(h_full_pre_w[3])
                    );

   
endmodule // hp_byte

   
