revaldinho/opc/opc7hp/synthesis/tangnano20k/tn20k_pll.v

/**
 * PLL configuration
 *
 * This Verilog module was generated automatically
 * using the gowin-pll tool.
 * Use at your own risk.
 *
 * Target-Device:                GW2AR-18 C8/I7
 * Given input frequency:        27.000 MHz
 * Requested output frequency:   54.000 MHz
 * Achieved output frequency:    54.000 MHz
 */

module tn20k_pll(
        input  clock_in,
        output clock_out,
        output locked
    );

    rPLL #(
        .FCLKIN("27.0"),
        .IDIV_SEL(0), // -> PFD = 27.0 MHz (range: 3-500 MHz)
        .FBDIV_SEL(1), // -> CLKOUT = 54.0 MHz (range: 3.90625-625 MHz)
        .ODIV_SEL(16) // -> VCO = 864.0 MHz (range: 500-1250 MHz)
    ) pll (.CLKOUTP(), .CLKOUTD(), .CLKOUTD3(), .RESET(1'b0), .RESET_P(1'b0), .CLKFB(1'b0), .FBDSEL(6'b0), .IDSEL(6'b0), .ODSEL(6'b0), .PSDA(4'b0), .DUTYDA(4'b0), .FDLY(4'b0), 
        .CLKIN(clock_in), // 27.0 MHz
        .CLKOUT(clock_out), // 54.0 MHz
        .LOCK(locked)
    );

endmodule
