revaldinho/opc/system/blackice/ram_3584_32.v

module ram ( input [31:0] din, output [31:0] dout, input[11:0] address, input rnw, input clk, input cs_b);

`ifdef simulate
 parameter MEM_INIT_FILE = "monitor.mem";
`else
 parameter MEM_INIT_FILE = "monitor_syn.mem";
`endif

   reg [31:0] ram [0:3583];
   reg [31:0] dout;

   initial begin
      if (MEM_INIT_FILE != "") begin
         $readmemh(MEM_INIT_FILE, ram);
      end
   end

   always @(posedge clk)
     if (!cs_b) begin
        if (!rnw)
          ram[address] <= din;
        dout <= ram[address];
     end
endmodule
