revaldinho/opc/opc5/opc5tb.v

`timescale 1ns / 1ns
`define HALT 10'b00_0000_0000
`define EXEC 3'b100

module opc5tb();
  reg [15:0] mem [ 65535:0 ];
  reg clk, reset_b;

  wire [15:0] addr;
  wire rnw ;
  wire ceb = 1'b0;
  wire oeb = !rnw;
  wire [15:0]  data0 = mem[ addr ];
  wire [15:0]  data1 ;

  // OPC CPU instantiation
  opc5cpu  dut0_u (.address(addr), .datain(data0), .dataout(data1), .rnw(rnw), .clk(clk), .reset_b(reset_b));

  initial
    begin
      $dumpvars;
      $readmemh("test.hex", mem); // Problems with readmemb - use readmemh for now
      clk = 0;
      reset_b = 0;
      #1005 reset_b = 1;
      #500000000 $finish;
    end

  // Simple negedge synchronous memory to avoid messing with delays initially
  always @ (negedge clk)
    if (!rnw && !ceb && oeb && reset_b)
      mem[addr] <= data1;

  always
    begin
      #500 clk = !clk;
      //$display("%4x %2x %x", dut0_u.PC_q, dut0_u.ACC_q, dut0_u.LINK_q);
    end

  // Always stop simulation on encountering the halt pseudo instruction
  always @ (negedge clk)
    if (dut0_u.IR_q[10:0]== `HALT && dut0_u.FSM_q==`EXEC)
      begin
        $display("Simulation terminated with halt instruction at time", $time);
        $writememh("test.vdump",mem);
        $finish;
      end
endmodule
