revaldinho/opc/(commit log)

2017-04-03 Another opcode reassignment & bug fix for FSM imm/direct movement from fetch to rdmem to exec
    [opcasm.py, opccpu.v, opcemu.py]
2017-04-04 More encoding changes, fix a couple of bugs, lowest resource use in 9572 so far = 93% macrocells
    [opcasm.py, opccpu.v, opcemu.py]
2017-04-04 Improved emulator trace output, longer test assembler
2017-04-06 Oops, deleted a couple of lines too many...
2017-04-06 Add more example syntax in text case, full expressions
2017-04-06 Minor tidy up of asm output and emu trace
2017-04-07 Use reset_b to disable IOs
    [opccpu.v]
2017-04-25 restore test.s assembler file which somehow got lost
2017-05-02 bug fix on OR_q[10] assignment
    [opccpu.v]
2017-05-02 Bug fix for indirect operation in emu and asm
    [opcasm.py, opcemu.py]
2017-05-03 fixup one remaining ref to c
    [opcemu.py]
2017-05-03 jsemu: merge link and carry, trace link, trace operand
2017-05-03 bug fix emu + macro asm and fib.s
    [opcasm.py, opcemu.py]
2017-05-03 bug fix for carry in emu
    [opcemu.py]
2017-05-03 macro error check in asm
    [opcasm.py]
2017-05-03 Oops2 .. upper/lower case issue
2017-05-04 full recursive macro assembler in 66 lines
2017-05-04 expanded test case with macros
2017-05-04 Fix width of PC initialisation vector
    [opccpu.v]
2017-05-04 Verilog bug fix, remove SEC to fit CPLD
    [opcasm.py, opccpu.v, opcemu.py, opctb.v]
2017-05-06 Minor tidy up in assembler, name some regexp groups in asm
2017-05-07 Add ported assembler + first test case
2017-05-07 Add second testcase, update assembler to handle one byte instructions
2017-05-07 BUg fixed, JAL not working - simulation race to fix
    [opc2cpu.v]
2017-05-07 Emu bug fix + CPU now working but not fitting in CPLD
    [opc2cpu.v, opc2emu.py]
2017-05-07 Fix operand printing for one byte instr
    [opc2emu.py]
2017-05-07 Fix typo which didn't seem to break anything
    [opc2emu.py]
2017-05-08 Small optimisation - OR_q always takes data pin value after FETCH0
2017-05-16 Bug fix for new WRMEM state - GRF selection
    [opc5cpu.v]
2017-05-20 rough cut of opc5asm, simple test program, updated README
2017-05-21 small speedup of fib.s + predicate bug fix (temp) in verilog
    [opc5cpu.v]
2017-05-21 Add Ed's mod for the assembler, halt change for the testbench
2017-05-21 bug fixes and add memory dump compare to README
    [opc5asm.py, opc5tb.v]
2017-05-22 Fix pred. bug, add extra decoding for new instructions
    [opc5asm.py, opc5cpu.v, opc5emu.py]
2017-05-22 Verilog bug fix, test.s changes
    [opc5cpu.v, opc5emu.py]
2017-05-23 REplace SUB w ADC, ROR with 17bit ROR
    [opc5asm.py, opc5cpu.v, opc5emu.py]
2017-05-23 Bug fix emu adc, add adc test in test.s
    [opc5emu.py]
2017-05-23 Put operands in registers to track adc/add in test.s
2017-05-23 rename test.s to test1.s to avoid clash, fix verilog, improved checking in README.sh
    [opc5cpu.v]
2017-05-24 Implement predicate invert bit
    [opc5asm.py, opc5cpu.v, opc5emu.py, opc5tb.v]
2017-05-27 Add POP4/PUSH4 macros, cut 2 cycles from udiv32 inner loop
2017-05-29 Tidy up formatting in assembler and verilog file
2017-05-30 Add sqrt.s test case and include in README.csh
2017-06-02 Testbench halt condition fix - need to check FSM in exec state as well as content of IR_q
    [opc5tb.v]
2017-06-03 Fix git checking -correct version with overlap
    [opc5cpu.v]
2017-06-03 Final(?) OPC5 - overlap FETCH/EXEC, precompute GRF adr, defer Zero calc, FET1->EXEC skip, FET0,1 pred checks
    [opc5cpu.v]
2017-06-03 bug fix for operand out of range
    [opc5emu.py]
2017-06-04 Added print_hex4, better comments
2017-06-04 Much more minimal version of print_hex4
2017-06-04 Monitor: updated OSWRCH to poll for UART busy
2017-06-04 A Papoilio One / LogicStart Wing based OPC5 system
2017-06-04 opc5system: Implemented UART Rx functionality
2017-06-06 Refactored op5system to support multiple boards
2017-06-06 Added support for xc6slx9_starter board to op5system
2017-06-06 First cut of opc5ls + test files
2017-06-06 fix predicate parsing for instructions starting with z,n or c
    [opc5lsasm.py]
2017-06-06 Fix dest address for cmp operation
    [opc5lsemu.py]
2017-06-07 Update opc5lsasm.py
    Fix predicate encoding for nzc, ncz
    [opc5lsasm.py]
2017-06-07 Update opc5lsemu.py
    Attempt to fix carry behaviour for CMP/CMPC/SUB/SBC
    [opc5lsemu.py]
2017-06-07 Update opc5lscpu.v
    Attempt to fix carry behaviour on CMP/CMPC/SUB/SBC. Both BSWP & XOR are 'odd' numbered instructions - use IR_q[11] to distinguish instead of IR_q[8]
    [opc5lscpu.v]
2017-06-07 Minor fixes to avnet microboard build
    [opc5wrapper.v]
2017-06-07 Fix BSWP to write result into destination reg
    [opc5lsemu.py]
2017-06-07 Change code for inverting OR_q in SUB/CMP
    [opc5lscpu.v]
2017-06-07 Fix nzc, ncz predicate encodings
    [opc5asm.py]
2017-06-07 Monitor: switched to cmp and sub where it makes sense
2017-06-09 fix emu psr string in trace, carry save over ld/mov pc
    [opc5lsemu.py]
2017-06-10 monitor: replace fib sample with fastfib code
2017-06-10 first cut pi program not working
2017-06-11 bug fix on carry preservation over jumps
    [opc5lsemu.py]
2017-06-11 Monitor: print_regs shows sign flag
2017-06-11 monitor: fix flag corruption in single stepper when dst=pc
2017-06-12 Add interrupt handling
2017-06-12 Move interrupt vector to 0x0002
2017-06-12 Add interrupt check at end of WRMEM state as well as EXEC
2017-06-13 Interrupt bug fix, redirect more output to logs, less to screen
    [opc5lscpu.v]
2017-06-14 SWI no longer checks EI bit, reset EI on entry to interrupt routine, demote isrv_q bit
    [opc5lscpu.v, opc5lstb.v]
2017-06-14 Get RTI to appear in trace
2017-06-15 Revised interrupt scheme, slightly over line budget
2017-06-15 Fix interrupt counting
2017-06-15 Update interrupt handling - clear SWI on exiting interrupt routine
2017-06-15 Actually fix counting interrupts
2017-06-16 fix clken generator in TB
    [opc5lscpu.v, opc5lstb.v]
2017-06-16 Move reset resync to posedge
    [opc5lscpu.v]
2017-06-19 replace sync/mreq_b with vpa/vda ports
    [opc5lscpu.v, opc5lstb.v]
2017-06-20 opc5copro: Added tuberom.s source and updated Makefile
2017-06-20 Add opc5ls-xp dir and xp switch on README.csh
2017-06-21 opc5copro: fix from Ed to not load cable driver on 64 bit linux
2017-06-21 opc5system: remove unnecessary libusb-driver.so (again)
2017-06-21 opc5copro: remove unnecessary libusb-driver.so (again)
2017-06-22 save a couple of words
2017-06-23 opc5copro: fix a bug in the cache that eliminated the valid bit
    [memory_controller.v]
2017-06-25 Fix minor issue with comments having brackets on same line as MACRO decl
    [opc5lsasm.py]
2017-07-17 Refactor continues, system building for all boards and all three cpus
2017-07-17 Moved print_hex4 to a library as an example of shared code
2017-07-17 bug fix for 'in' instruction
    [opc6emu.py]
2017-07-20 copro: tuberom: Re-jigged memory layout, OSWRCH doesn't trash r12
2017-07-21 system: add complete byte of receive buffering to UART
2017-07-21 Move 2nd interrupt vector to 0x0004
2017-07-22 Performance bug fix - failed predicates should bug out directly from EXEC/FET0 to FET0 rather than EAED
    [opc6cpu.v]
2017-07-24 Carry same perf. bug fix back to opc5ls-xp
    [opc5lscpu.v]
2017-07-27 Reformat symbol table, count assembled bytes, save a line
2017-07-29 Use same code to dump hex as assembler
2017-07-29 Add byte/word counts and better symbol table listing to older machine assemblers
2017-08-02 squash macro code, handle inc with -ve imm, error on oversized short const
    [opc6asm.py]
2017-08-03 Unrecognized instruction reported in error list instead of bombing out in assembler
    [opc6asm.py]
2017-08-05 Add BYTE directive to assembler
2017-08-06 copro: fix Makefile generation of tuberom.c for PiTibeDirect
2017-08-06 copro: tuberom v 0.51: fix a recent bug in srec the causes random crashes
2017-08-09 Add local labels in assembler
2017-08-09 update opc5,opc5ls assemblers with opc5asm features
2017-08-09 initial bytewise assembler - basic version works as direct replacement for original, no extensions yet
    [opc6byteasm.py]
2017-08-09 add code to run byte or word assembler
2017-08-10 detect dec with -ve offset and replace with inc
    [opc6asm.py, opc6byteasm.py]
2017-08-10 Add _BPC_ current byte token for VM
2017-08-10 fix typo for byte current PC
    [opc6byteasm.py]
2017-08-10 Fix newline printing
2017-08-10 exit with non-zero status on errors
    [opc6asm.py, opc6byteasm.py]
2017-08-12 Fix local label handling
    [opc6asm.py, opc6byteasm.py]
2017-08-17 system: blackice, fixed PLL params
    [system.v]
2017-08-21 system: blackice, fixed PLL params again
    [system.v]
2017-08-21 system: blackice, fixed PLL params again, now in SIMPLE mode
    [system.v]
2017-08-21 system: blackice, hold OPC in reset if PLL not locked
    [system.v]
2017-08-24 system: blackice, switched to USB uart (needs IceBoot 0.3)
2017-08-26 Fix regexp for printing symbol table (missing symbols in listing)
    [opc6asm.py]
2017-08-27 Trace fix - INs were reported as LOADs in the trace
    [opc6emu.py]
2017-08-31 Allow \n,\r,\006 etc escaped codes in (U(B))STRING directives in OPC5LS and OPC6 assemblers
2017-09-02 use constant to define board size/number of queens
2017-09-13 Rough cut of BCPL tests and BBC ssd build script
2017-09-22 Match digit count in BCPL pi to assembler versions for benchmarks later
2017-09-23 gzip trace files, add str2numb()+getkey() to bcpllib.b
2017-10-04 Make values <31 print space
2017-10-10 use 32 digits for assembler and BCPL pi tests
2017-10-28 Add OPC7 trace regexp
2017-10-31 revise src_q reg handling to remove a little logic from FET
2017-10-31 Predicate check in EAD only - remove more logic from FET
2017-10-31 Reinstate pred check in FET/EXEC - cycle savings too large to lose
    [opc7cpu.v]
2017-11-01 monitor: changed print_hex_4 to print_hex_word
2017-11-02 monitor: moved disassembler into a library, first cut at an opc7 implementation
2017-11-02 Make 20b imm in illegal zone an error rather than a warning
    [opc7asm.py]
2017-11-02 Fix default memory size, refactor preprocessing
    [opc7asm.py]
2017-11-04 Fix bperm bit control
    [opc7cpu.v]
2017-11-05 Update README with makefile for running assembler tests
2017-11-07 system: updated Makefile for 64-bit Ubuntu (fingers crossed)
2017-11-07 system: added opc7 support for all supported boards (avnet, papilio one, xc6slx9 starter)
2017-11-07 system: move UART to IO space (in opc6/opc7)
2017-11-07 system: corrected default A/D size for opc5ls/opc5
    [system.v]
2017-11-07 system: correct testbench to look for the UART in IO space
    [system_tb.v]
2017-11-15 opc7asm: fixed a bug in STRING pseudo-op
    [opc7asm.py]
2017-11-16 Fix opc7 assembler string handling
    [opc7asm.py]
2017-11-19 copro: opc7: fix generation of C version of tuberom
2017-11-21 copro: opc7: fixed printdec library
2017-11-21 copro: tuberom version 0.52
2017-11-28 copro: OSWORD now working, *TEST calculates N digits of Pi and prints time
2017-11-28 copro: tuberom version 0.53
2017-11-29 copro: opc7: fixed a write bug in memory controller
    [memory_controller.v]
2017-11-29 system: blackice opc7: added external memory controller, 25MHz currently (cache timing)
2017-11-29 system: blackice opc7: fixes a possible write bug in memory controller; improved comments
    [memory_controller.v]
2017-11-30 copro: correctly generate opc5ls tuberom.c file for PTD
2017-11-30 system: added trace flag command to monitor to control output of single stepper
2017-12-01 system: blackice opc7: added power-on reset generation
    [system_32.v]
2017-12-01 system: blackice opc7: remove hole at E00-FFF
2017-12-02 BCPL:Fix Tube ROM location for OPC6
2017-12-02 BCPL: correct OPC6 stack/free mem pointer for latest Tube ROM setup
2017-12-03 BCPL: bugfix on CASE default behaviour
2017-12-05 copro: tuberom version 0.54
2019-03-03 bug fix for overlapped FET/EXEC instr needing to have second operand
    [opc8cpu.v]
2019-03-04 add OPC8 first cut assembler
2019-03-05 asm bug fixes, and partly working emulator - runs fib.s ok
    [opc8asm.py, opc8emu.py]
2019-03-05 Emulator + pi spigot bug fixes but still debug to do
    [opc8emu.py]
2019-03-07 truncating hex files between assembler and emulator for OPC8
2019-03-07 bug fix in EMU + bigsieve test
    [opc8emu.py]
2019-03-09 Misc updates to assembler and histogram utility to report stats for OPC7,8
2019-03-09 No sign ext. on RSRC=R0;BROT/BROL replace BPERM;Fix Histogram code to work with OPC7/8
    [opc8asm.py, opc8cpu.v, opc8emu.py]
2019-03-10 remove lcmp instruction in case deleted from OPC8 set
2019-03-10 gzip test traces and dumps; update histogram code to read gzipped files
2019-03-10 Add OPC8 math24.s tests, gzip traces in Makefile, BSTRING, BROL, BROR bug fixes in asm/emu
    [opc8asm.py, opc8emu.py]
2019-03-10 Add null to stdout at end of tests to avoid non-zero result in high mem.
    [opc8emu.py]
2019-03-10 Verilog TB added + bug fixes in Verilog CPU to pass at least the small fib test
    [opc8asm.py, opc8cpu.v, opc8tb.v]
2019-03-11 bug fix predicates - cant reuse OR_q for predicate ref unlike opc7 because of second fetch. Use 3 additional register bits
    [opc8cpu.v]
2020-02-21 Correct address port name to ensure compilation for Blackice etc, remove some ifdef experimental code
    [opc7cpu.v, opc7tb.v]
2020-02-23 Update system for Xilinx FPGAs to use lookahead interface on CPU and additional FFs for UART signals
2020-02-25 Update OPC7 Pi spigot and make asm listing/emu trace work with histogram program
2020-02-26 Allow predicate checking in FET/EXEC for 12% cycle efficiency improvement
2020-02-26 More testbench fixes for synchronous memory interface operation
    [opc7tb.v]
2020-05-05 copro: tuberom version 0.55
2026-10-24 Add -q quiet switch
2026-10-24 Ensure TRACE on for std tests to be able to generate all dynamic stats
2026-10-25 bcpllib setbit/testbit: shift and mask instead of divide and MOD
    bitno/bitsperword and bitno MOD bitsperword compiled to calls of the OPC
    software divide routines; they are now bitno >> (B2Wsh+3) and
    bitno & (bitsperword-1) (bitsperword is a power of 2, bitno >= 0). The
    mask 1<<s is still computed on each call.
    New test bittest.b (OPC7 only): set and clear bits 0-319 checking the old
    state setbit returns and what testbit reads back, then a bit vector sieve
    to 20000. On OPC7 it runs 69% fewer instructions (29.1M -> 9.1M, about
    426 -> 132 per call including the caller's loop).
    claude-tests clean-extra also removes the divtest and bittest outputs, so
    make ARCH=opc6 clean leaves none behind.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
2026-10-25 sial2opc -o: inline / and MOD by constant powers of 2
    New optimisation OPT-3 turns a constant 2**k loaded just before div or mod
    (l Kn or atbl Kn, keeping atbl's b := a) into new extension opcodes
    ext_divp2/ext_modp2 Kn (ext_sial.h, 167 and 168), translated inline
    instead of calling the divide routines (about 150 instructions):
    b / 2**k mov r1,r2; mi.add r1,r0,2**k-1; k x asr (2+k)
    b MOD 2**k b - ((b rounded as above) & -2**k) (5)
    so / truncates towards zero and MOD takes the dividend's sign, as BCPL
    requires. Up to 2**14 on OPC6 and 2**23 on OPC7, where constants over
    16 bits use r8. Larger and negative constants, and xdiv/xmod, still
    call the routines.
    OPC7 instru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
2026-10-27 scmp test; opc7asm negative WORD values; s14 mnemonic in the C emulator
    - opc7/tests/scmp.s: scmp over all pairs of 12 values (0, +-1, +-2, 3, 5,
    maxint, minint, minint+1, 0x40000000, 0xBFFFFFFF). It checks each result
    against an unsigned compare with the sign bits flipped, and that scmp
    leaves its registers alone. The expected output is in the header comment.
    - opc7asm.py: WORD values are written as 32 bit two's complement. A negative
    WORD went into the hex file as '-0000001', which $readmemh rejects, so the
    Verilog testbench loaded only part of the program. Values outside 32 bits
    are now an error.
    - opc7asm.py: the symbol table heading printed a literal "\n" since it
    became a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
2026-11-05 Add 'never' 0. predicate to the assembler and trace output from the emulators; fix bug in opc7cpu.v to make pred 001 match the emulator
2026-11-09 OPC7 syslib: gbyt/pbyt through jump tables on the byte number
    Each entry point splits the byte address into word address and byte
    number, then jumps through a table instead of testing all four bytes
    (gbyt) or branching through a compare chain (pbyt). The jump is
    pc-relative (add r7,pc,table-PC; mov pc,r7), so it works wherever the
    syslib lands. Registers used are as before. 11 more words of code.
    All claude-tests pass against native output and all 49 bcpltests
    outputs are unchanged. Cycles: -0.29% on the 12 claude-tests for the
    pipelined opc7hpcpu model (-0.19% opc7cpu), up to -3.8% on
    string-heavy programs, no program slower.
2026-11-11 opc7hp: the Harvard, pipelined OPC7 and its FPGA system
    A new top-level directory for the alternative OPC7 implementation, kept apart
    from the original one-page-computing tree, which it uses for opc7cpu.v, the
    emulators, the assembler and the test programs:
    cpu/ opc7hpcpu.v (four-stage pipeline, iwait/dwait, hlt), the
    reference opc7hcpu.v, the testbench and the checks: traces
    against opc7emu, STORE/OUT against opc7cpu, directed hazard
    tests, random interrupts and random memory waits
    system/ the FPGA system (boot ROM, RAM, UART, GPIO) and its
    simulation, which runs the BCPL test programs over the UART
    software/ BCPL s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
2026-11-11 OPC7 spec: correct and extend the text
    Describe the PSR layout and which instructions set which flags (carry also
    from shifts and rotates; zero not on stores, out, pc writes or rti; scmp's
    sign), that a failed predicate changes no flags, r15 reads and writes,
    getpsr ignoring its immediate, scmp for signed compares, and that interrupts
    need EI and save the flags, V included, for rti to restore.
2026-11-11 rti restores V in all OPC7 RTL, as the emulators do
    The interrupt-saved flags (PSRI) are now 5 bits: V, EI, S, C, Z. rti
    restores them and still clears SWI. Applies to opc7/opc7cpu.v,
    opc7hp/cpu/opc7hcpu.v and opc7hp/cpu/opc7hpcpu.v.
    haz_int gains two checks that fail on the old RTL: a software interrupt
    entered with V set, and V read in the main loop under random hardware
    interrupts. Full regression, int_check, wait_check, the 57 system
    programs and synthesis all pass with the fix.
2026-11-12 opc7hp: ready for the first Tang Nano hardware test
    - tn20k_sys: button S1 (pin 88) resets the system while held; its idle
    level is sampled at power-on reset, so either polarity works
    - software/echo: UART echo test for both directions, with its expected
    output and input for simulation
    - sys_tb +resets=N (SIMARGS in sysrun.sh): rerun the program after
    resets from the RAM it left, as the button does; hello and echo pass
    - tangnano20k/README.md: files, bring-up steps and fault table
2026-11-13 opc7 syslib: wrch and rdch first in __sys; support for the bcplcgopc7.b back end
    __sys now tests for Sys_sawrch and Sys_sardch before making a frame and goes
    straight to __sys_wrch / __sys_rdch, which do what __Sys_sawrch and
    __Sys_sardch did (the same registers saved, the character from P!4). Print-bound
    programs run 10-17% fewer cycles (hello, writef, bbctest; fact 10%).
    For the OCODE back end bcplcgopc7.b (not yet committed), additions only:
    - sial2opc.py -a/--asm <file>: include the back end's assembler after the
    translated SIAL, with its "## GLOBAL n label" lines in the global vector;
    "## REGARGS" (its calling convention) points global 3 at __sys_regargs and
    is refused with SIAL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
2026-11-13 opc7hp synthesis: results with mulstep and divstep (834d013), both boards
    5 seeds each (Tang Nano opc7hp with -nowidelut). Medians against the
    previous lines:
    Tang Nano opc7hp 109.9 MHz (112.8 before), opc7 72.9 MHz (76.4)
    ULX3S opc7hp 81.6 MHz (78.0 before), opc7 62.8 MHz (67.0)
2026-11-13 tangnano20k: first hardware test passed (hello and echo)
    hello and echo, built from 05983a4, run on a Tang Nano 20K: the PLL clock,
    the UART's TX (69) and RX (70) pins, S1 reset (88) and the LED5 halt work
    as constrained. The README records the results, which serial port is which,
    and notes on the LiteX demo in the board's flash and on terminals.
